WeActStudio/WeActStudio.MiniSTM32F4x1/Soft/README-zh.md

# 软件

* [English Version](./README.md)

1. `WeAct HID FW Bootloader` C语言开发程序下载工具，本工作室根据官方HID bootloader制作的图形化操作下载程序软件，更方便

2. `WeAct Studio Download Tool` 本工作室制作的下载工具，可以通过串口和USB下载程序或固件，可用于micropython固件的烧录或程序下载，非常好用，推荐！

3. `STM32_HID_Bootloader` C语言开发官方HID bootloader,想了解更多请访问
 <https://github.com/WeActStudio/STM32_HID_Bootloader.git>

4. `STM32CubeProgmmer` STM32官方下载工具,下载请访问[ST WebSite](https://www.st.com/content/st_com/en/products/development-tools/software-development-tools/stm32-software-development-tools/stm32-programmers/stm32cubeprog.html)

5. `WeActToolBox` 网络调试助手和串口调试助手

6. 更多软件 && `STM32CubeProgmmer` 等软件 百度云下载地址

``` c
链接：https://pan.baidu.com/s/1Ugz7GwJ0j41GaBrUv0c0Og 
提取码：lhla
```
