WeActStudio/WeActStudio.MiniSTM32F4x1/Soft/README.md

# Soft 软件

* [中文版本](./README-zh.md)

1. `WeAct HID FW Bootloader` C language development program download tool.Our studio according to the official HID Bootloader made graphical operation to download the program software, more convenient

2. `WeAct Studio Download Tool` Our studio produced download tools, can be through the serial port and USB download program or firmware, can be used for microPython firmware burning or program download, very easy to use, recommended!

3. `STM32_HID_Bootloader` C language development official HID Bootloader, want to learn more please visit
 <https://github.com/WeActStudio/STM32_HID_Bootloader.git>

4. `STM32CubeProgmmer` STM32 official download tool, download please visit[ST WebSite](https://www.st.com/content/st_com/en/products/development-tools/software-development-tools/stm32-software-development-tools/stm32-programmers/stm32cubeprog.html)

5. `WeActToolBox` Network speed view && Serial Port view widget

6. More software  && `STM32CubeProgmmer` BaiDu Downdown link:

``` c
链接：https://pan.baidu.com/s/1Ugz7GwJ0j41GaBrUv0c0Og
提取码：lhla
```
