WeActStudio/WeActStudio.MiniSTM32F4x1/SDK/README-zh.md

# SDK 描述

* [English Version](./README.md)

|目录名称|解释
|:--:|:--:|
|CMSIS-DAP|CMSIS-DAP 固件可以让我们的核心板刷成下载烧录器|
|MicroPython_Example|MicroPython 例程|
|STM32F401CEU6|STM32F401CEU6 相关资料.STM32F401CCU6 升级版本, 更大内存|
|STM32F411CEU6|STM32F411CEU6 相关资料|
