WeActStudio/WeActStudio.MiniSTM32F4x1/SDK/README.md

# The SDK description

* [中文版本](./README-zh.md)

|Dir name|Explain
|:--:|:--:|
|CMSIS-DAP|CMSIS-DAP Firmware allows the core board to be brushed into the download debugger|
|MicroPython_Example|MicroPython Example|
|STM32F401CEU6|STM32F401CEU6 related information.STM32F401CCU6 upgrade, more memory|
|STM32F411CEU6|STM32F411CEU6 related information.|
