WeActStudio/WeActStudio.MiniSTM32F4x1/SDK/CMSIS-DAP/README-zh.md

# CMSIS-DAP 固件

* [English Version](./README.md)

* 固件支持stm32f401ccu6,stm32f401ceu6,stm32f411ceu6
* 接口为核心板引出的SW调试接口

|我们的核心板|目标板|
|:--:|:--:|
|3V3|3V3|
|SWDIO|SWDIO|
|SWCLK|SWCLK|
|GND|GND|
