WeActStudio/WeActStudio.MiniSTM32F4x1/SDK/STM32F401CEU6/README-zh.md

* [English Version](./README.md)
## 目录说明

``` c
├─HAL             STM32 HAL库例程
├─MicroPython     MicroPython 固件
└─STD             STM32 标准库例程
```
