WeActStudio/WeActStudio.MiniSTM32F4x1/SDK/STM32F401CEU6/README.md

* [中文版本](./README-zh.md)
## Directory

``` c
├─HAL             STM32 HAL example
├─MicroPython     MicroPython firmware
└─STD             STM32 STD example
```
