WeActStudio/WeActStudio.MiniSTM32F4x1/SDK/STM32F401CEU6/STD/README-zh.md

# STD标准库示例程序

* [English Version](./README.md)

1. `stm32f4x1_Templates` 模板工程
2. `stm32f4x1_Templates_HIDFlash-easydownload` 模板工程&&HIDFlish APP
3. `stm32f4x1_TIM_PWMOutput` PWM 测试
