WeActStudio/WeActStudio.MiniSTM32F4x1/SDK/STM32F401CEU6/STD/README.md

# STD sample project

* [中文版本](./README-zh.md)

1. `stm32f4x1_Templates` Templates project
2. `stm32f4x1_Templates_HIDFlash-easydownload` Templates project&&HIDFlish APP
3. `stm32f4x1_TIM_PWMOutput` PWM test
