WeActStudio/WeActStudio.MiniSTM32F4x1/SDK/STM32F411CEU6/HAL/GPIO/GPIO_IOToggle/README.md

# HAL GPIO IO Toggle

This is a tutorial to implement a simple IO level reversal

# There are the creation procedures

## First: choose Pin and choose debug mode

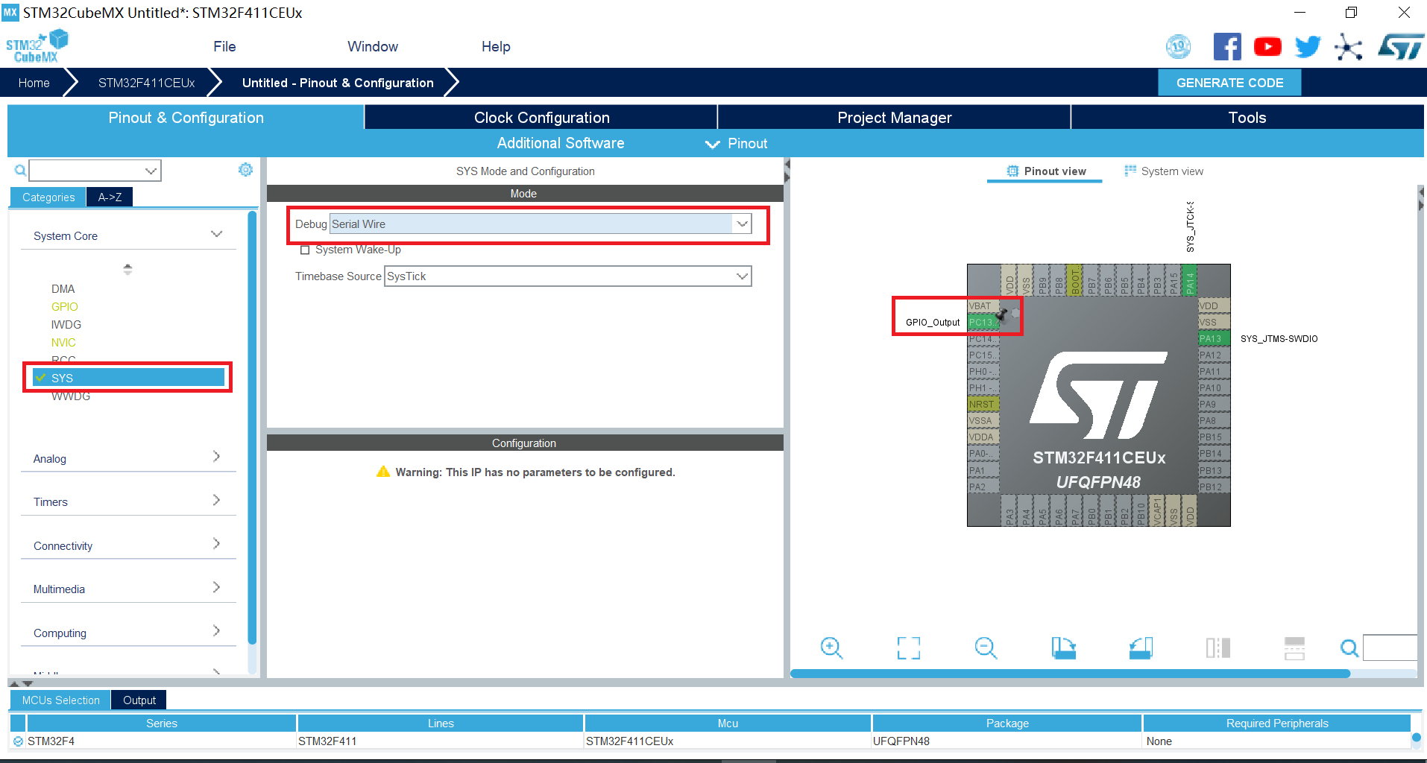
[picture p13: SDK/STM32F411CEU6/HAL/GPIO/GPIO_IOToggle/Images/1.PNG]
first


## Second: choose RCC and choose crystal resonator

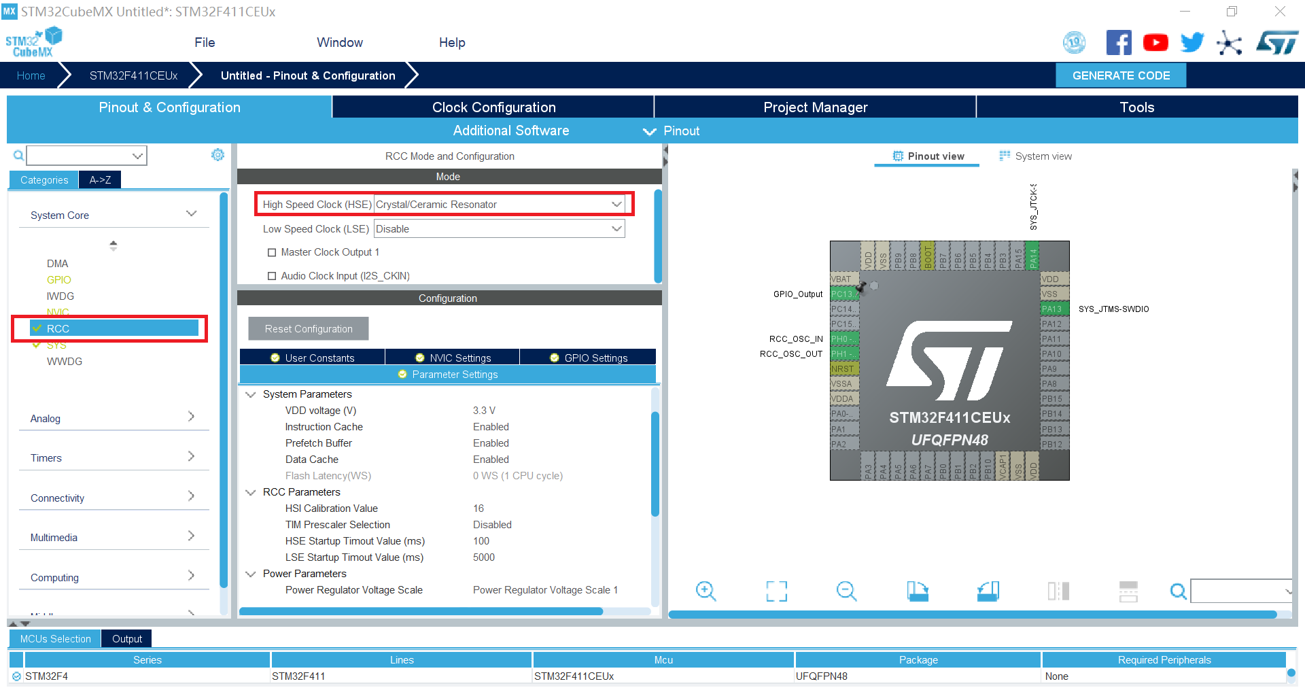
[picture p14: SDK/STM32F411CEU6/HAL/GPIO/GPIO_IOToggle/Images/2.PNG]
second


## Third: set GPIO attribute

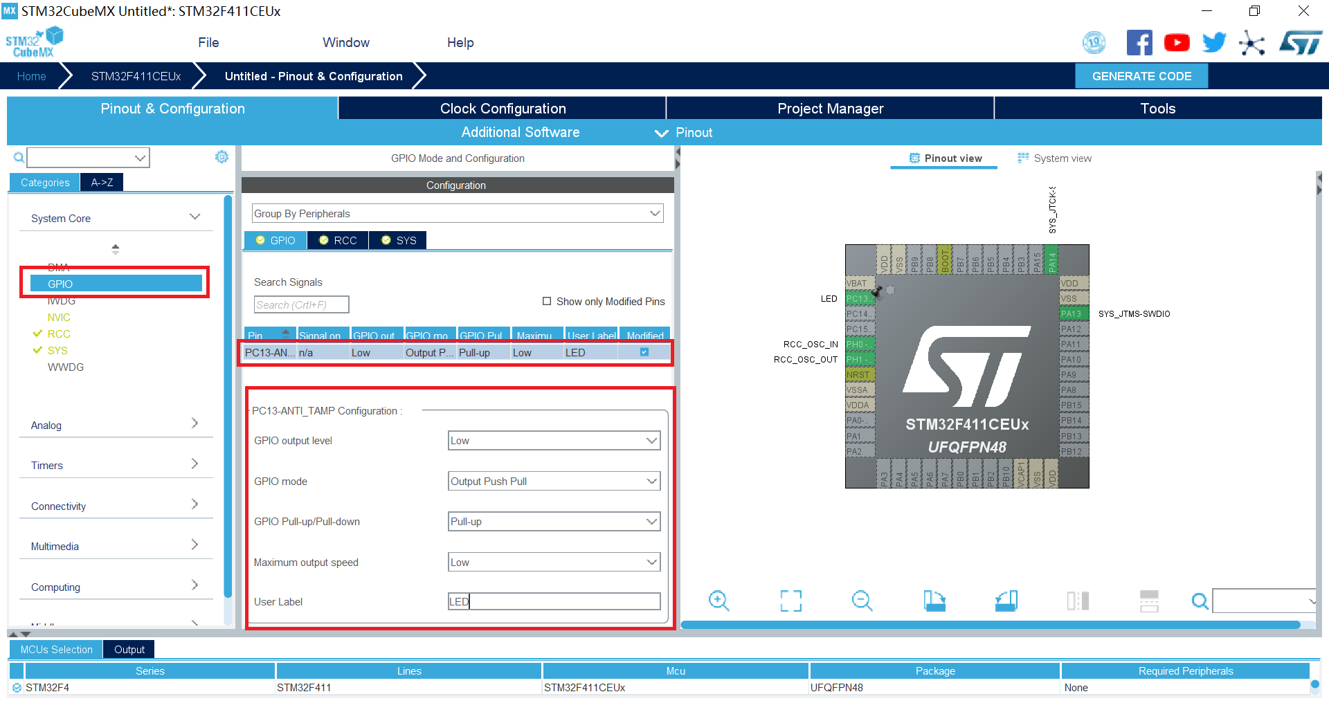
[picture p15: SDK/STM32F411CEU6/HAL/GPIO/GPIO_IOToggle/Images/3.PNG]
third


## Forth: clock configuaraton choose HSE

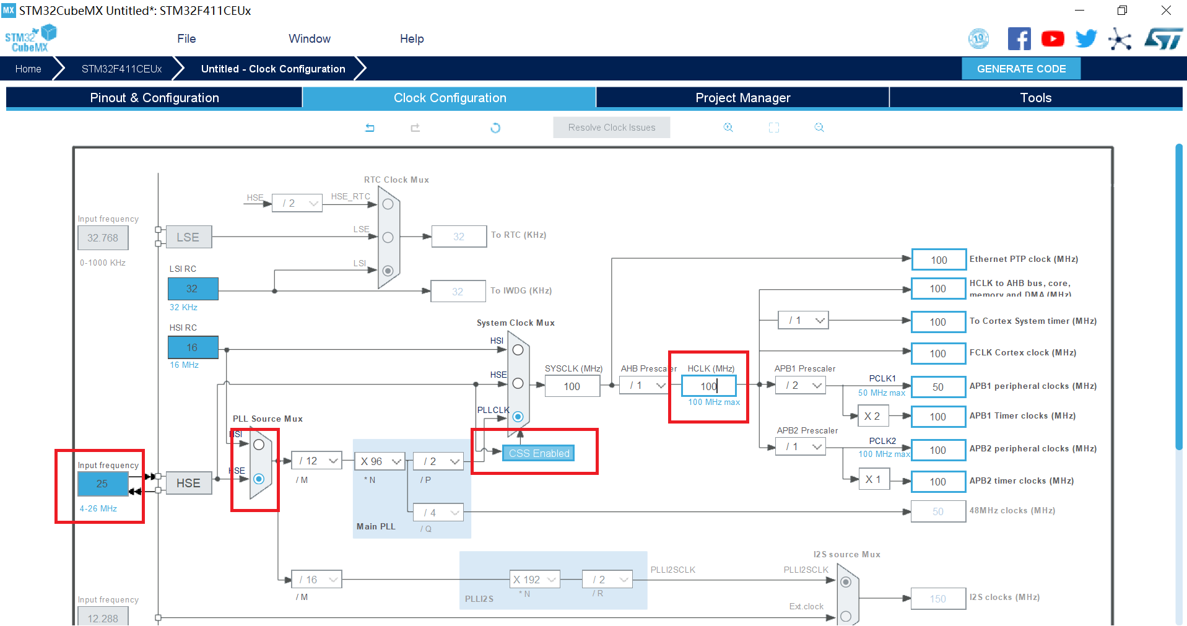
[picture p16: SDK/STM32F411CEU6/HAL/GPIO/GPIO_IOToggle/Images/4.PNG]
forth


## Fifth: set project name, location and your IDE

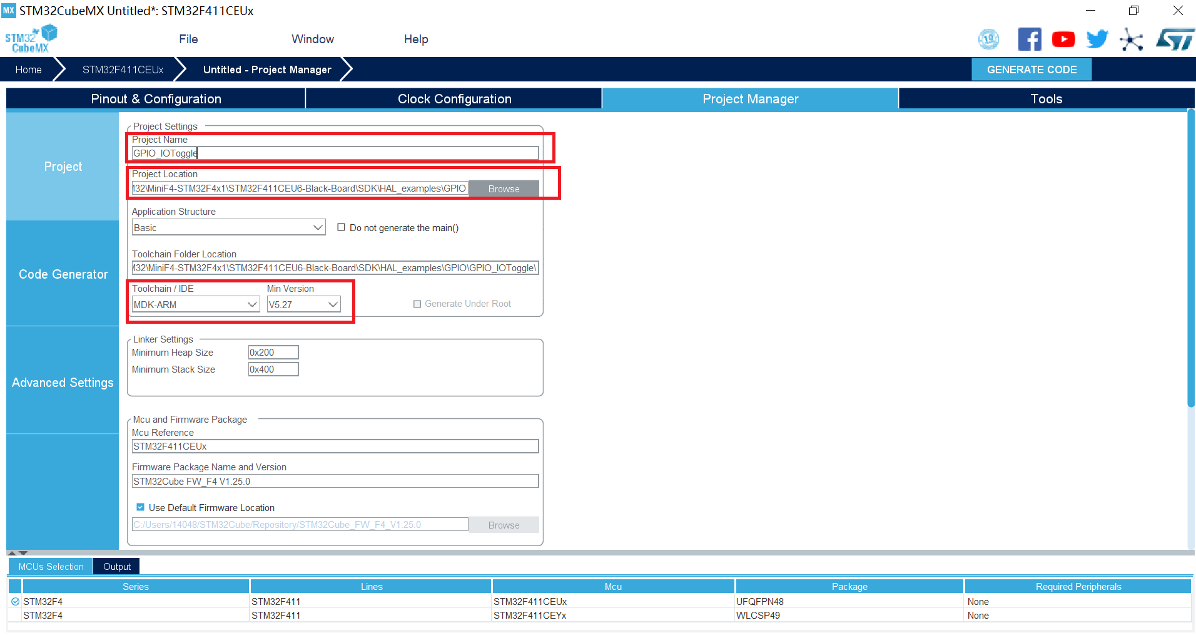
[picture p17: SDK/STM32F411CEU6/HAL/GPIO/GPIO_IOToggle/Images/5.PNG]
fifth


## Sixth: generate peripheral initialization(.c or .h) and generate the code

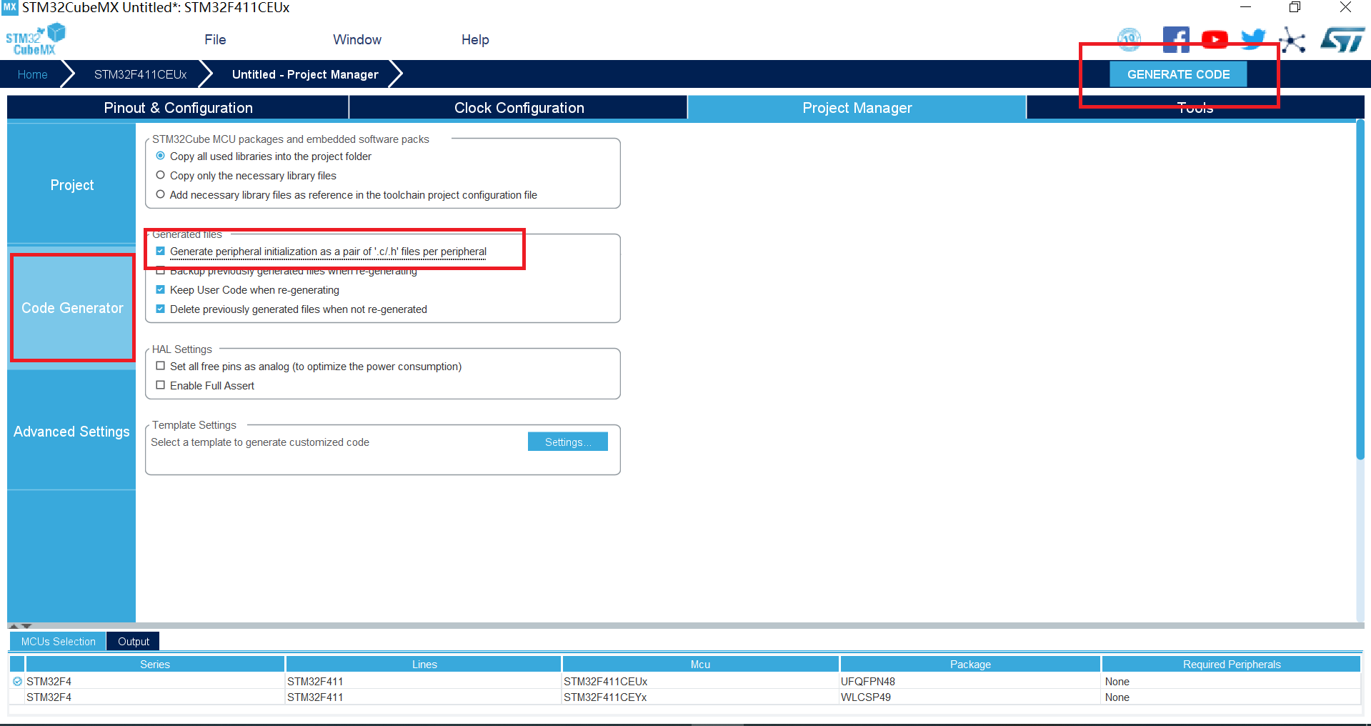
[picture p18: SDK/STM32F411CEU6/HAL/GPIO/GPIO_IOToggle/Images/6.PNG]
sixth
