WeActStudio/WeActStudio.MiniSTM32F4x1/Soft/WeAct_Toolbox/README.md

# WeAct ToolBox

## Network speed view && Serial Port view widget

## 网速查看&&串口查看小工具

V1.0 Initial Release

V1.1 Add KeyBoard `CAPSLOCK`&&`NUMLOCK` Display

V1.2 Add Mouse Double Click 
```
Double Click Network speed view Open Windows Start
Double Click COMx Open Device manager
Double Click KeyBoard Display Close `CAPSLOCK`&&`NUMLOCK`
```

> support English and Chinese

WLAN Tx:1 MB,Rx:1 MB
