WeActStudio/WeActStudio.MiniSTM32F4x1/SDK/STM32F401CEU6/HAL/06-F401_ST7735/README.md

# 重要说明 Important Note

* 中文：如果需要显示图片需要将图片为16位图

* English: If you want to display an image you need to make it a 16-bit image！
