WeActStudio/WeActStudio.MiniSTM32F4x1/images/F4x1Copy-1.png

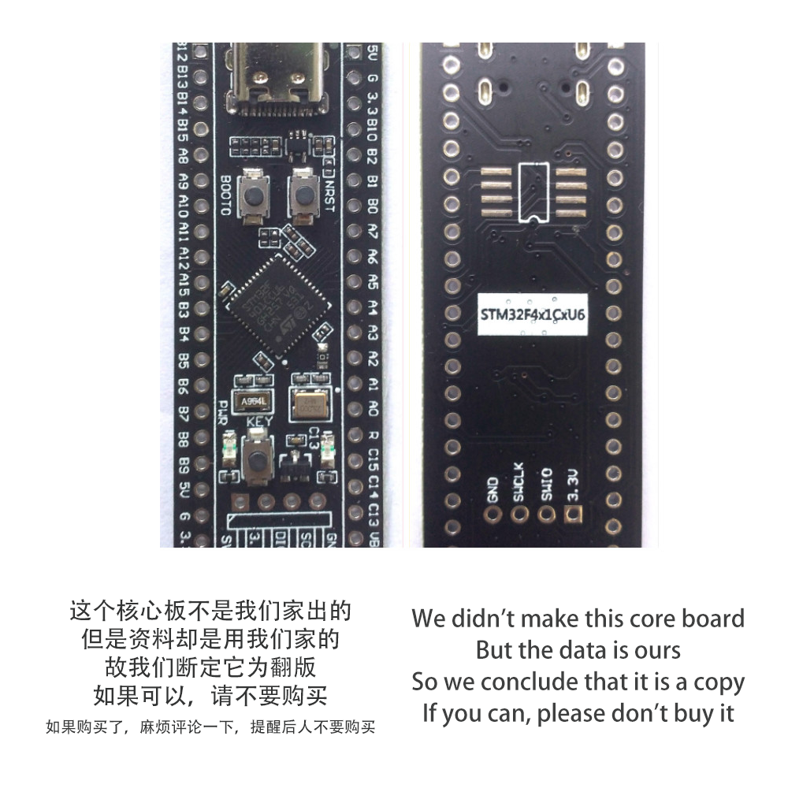
images/F4x1Copy-1.png
