WeActStudio/WeActStudio.MiniSTM32F4x1/images/STM32F4x1-V30_3D.jpg

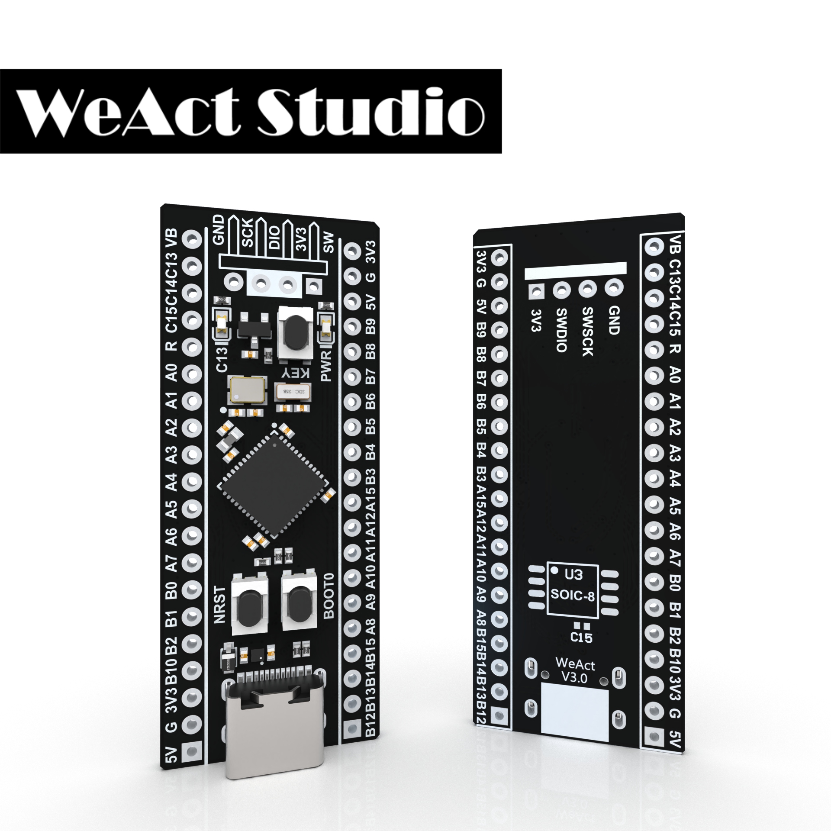
images/STM32F4x1-V30_3D.jpg
