WeActStudio/WeActStudio.MiniSTM32F4x1/images/STM32F401-3D-Model-Render/top&bottom.jpg

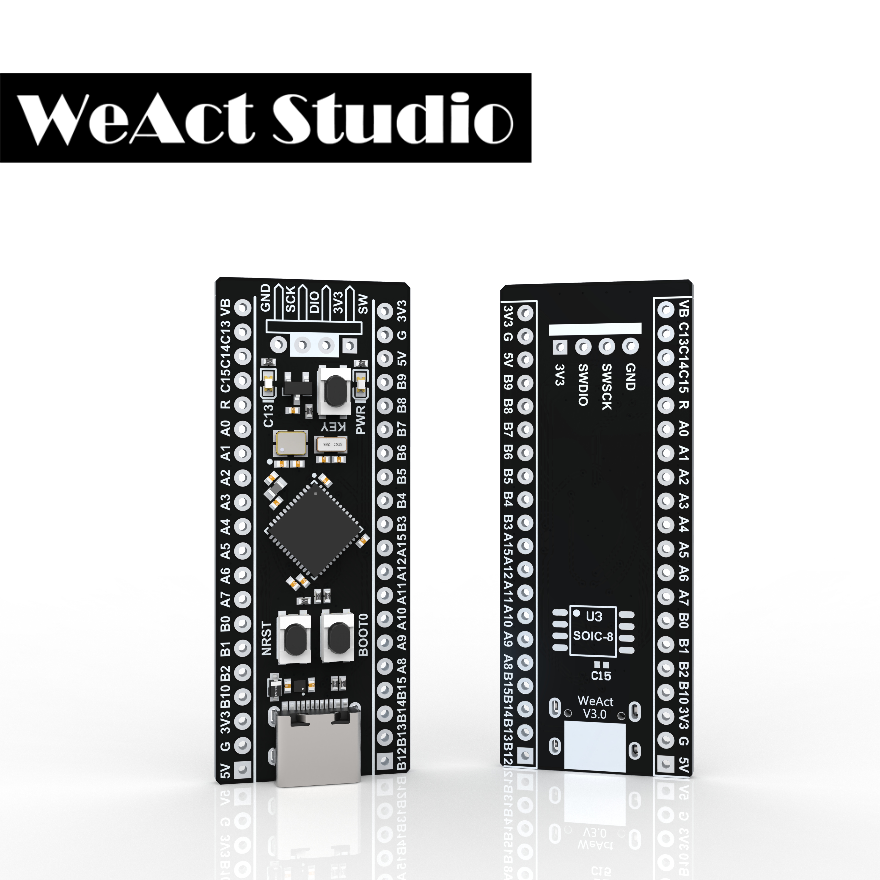
images/STM32F401-3D-Model-Render/top&bottom.jpg
