WeActStudio/WeActStudio.MiniSTM32F4x1/images/STM32F401-3D-Model-Render/top.jpg

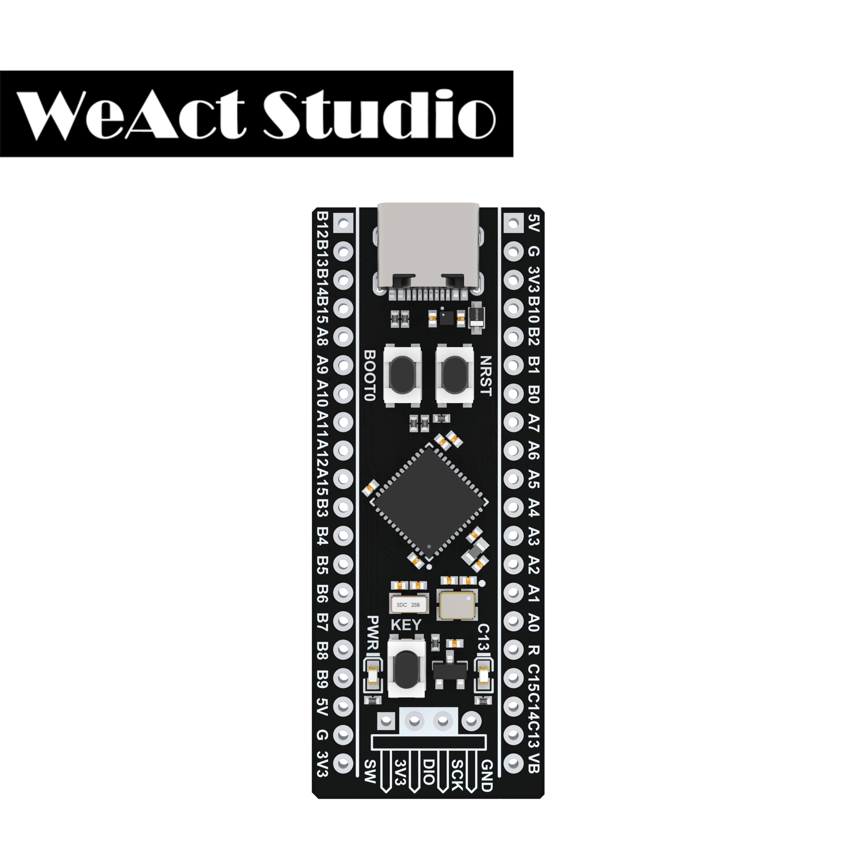
images/STM32F401-3D-Model-Render/top.jpg
