WeActStudio/WeActStudio.MiniSTM32F4x1/images/STM32F411-3D-Model-Render/side.jpg

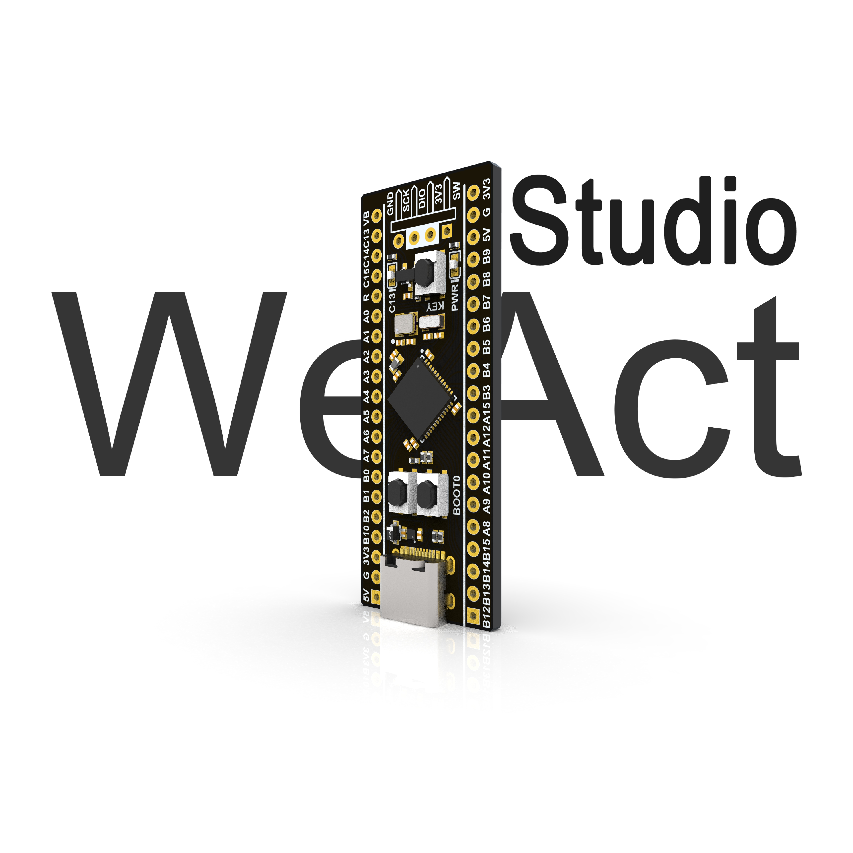
images/STM32F411-3D-Model-Render/side.jpg
