WeActStudio/WeActStudio.MiniSTM32F4x1/Soft/STM32_HID_Bootloader/pictures/Arduino_IDE_1_8_9.PNG

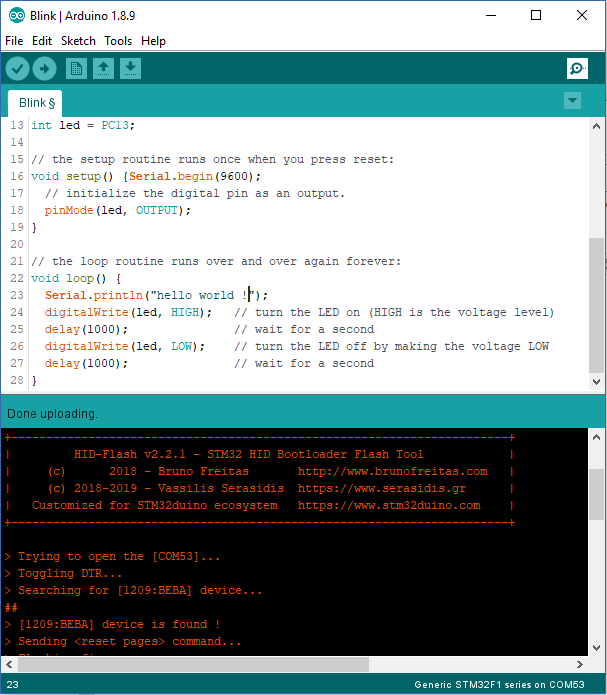
Soft/STM32_HID_Bootloader/pictures/Arduino_IDE_1_8_9.PNG
