WeActStudio/WeActStudio.MiniSTM32F4x1/(threads)

Thread 1 (2020-01-19):

Not powering on using USB-C cable with E-Mark

thinxer, 2020-01-19:
I'm having problem connecting the board to MacBook Pro with the default USB-C to USB-C cable, which has a E-Mark chip. The board is not powering on at all. It is working well with a USB-C cable without E-Mark, or a USB-A to USB-C cable.

Looking at the V20 Schematics, I noticed that the 2 CC pins are shorted. The board should have a 5.1kOhm pulldown resistor on each of the CC1 and CC2 lines, not shorting them.

It seems that Raspberry Pi 4B has made a similar mistake. Here is a in-depth analysis: https://hackaday.com/2019/07/16/exploring-the-raspberry-pi-4-usb-c-issue-in-depth/.

WeActTC, 2020-01-20:
Hi, because most USB-C cables do not have E-Mark chips, and this situation was not considered at the time, the board can work well with USB-C cables without E-Mark. Thanks for your feedback. We will improve in the next batch of products, each CC will add 5.1kΩ resistance.

thinxer, 2020-01-20:
Thanks for the response. I believe it should be better to leave this issue open so that we can track the progress. People experiencing the same issue thus could subscribe to this issue and get notified when the new batch is ready.

samveen, 2020-02-05:
@thinxer I noticed that V2.1 has one of the CC pins grounded via 5.1kOhm resister (R9), but not the other. Would you review: https://github.com/WeActTC/MiniF4-STM32F4x1/blob/master/STM32F401CCU6-Black-Board/HDK/MiniF4x1Cx_V21%20SchDoc.pdf

thinxer, 2020-02-05:
@samveen The two CC pins  are using the same PIN name and thus shorted, not that one of them is floating.

kamilion, 2020-02-20:
There needs to be two 5.1k ohm resistors to make e-marked cables work properly.

One for CC1, one for CC2.

Trying to share one resistor by linking both CC1 & CC2 together through the same resistor is what causes the E-mark problem.

This causes enumeration of the device as a passive headphone adapter that requires no power, and as such, none is delivered.

Also, the v2.1 board has another problem: Pressing Boot0 and Key at the same time causes a deadshort between 3.3v and GND. Another resistor like R6 added between key and ground will solve this current from becoming too large and causing the board to burn up due to unintended deadshort.

thinxer, 2020-03-02:
The issue has been resolved in V2.2 by e6cc12705.

Closed 2020-03-02.

Thread 2 (2020-01-28):

External power supply + USB at the same time

flatpedals, 2020-01-28:
Regarding the 411CE v1.3, is there any protection in place that would allow connecting USB and an external 5V source at the same time? Is this recommmended?
Thank you!

WeActTC, 2020-01-28:
Hello, it is not recommended to use external power supply and usb at the same time, because there is no diode protection. Common ground is fine, or connect a diode in a `5V Pin` to prevent current backflow to the usb.We will make corresponding improvements in the next hardware version

cgo, 2021-01-13:
Does this problem also persist in the 3.0 board with F401CEU?

flatpedals, 2021-01-13:
afaik, v3 has a diode in place for this specific issue. I had a v3 F411 for a short while and the diode was there but I didn't test. Maybe check the diagrams, but I think it has been fixed.

cgo, 2021-01-13:
Thanks @flatpedals

Thread 3 (2020-02-04):

Schematics missing

samveen, 2020-02-04:
The repository is missing the schematics of the board. I am trying to understand how to attach an SPI flash memory chip to the F401 version of the board, but without the schematics, I am unable to figure out the details.

WeActTC, 2020-02-04:
Hi,
The schematic of F401 is here：
[https://github.com/WeActTC/MiniF4-STM32F4x1/tree/master/STM32F401CCU6-Black-Board/HDK](https://github.com/WeActTC/MiniF4-STM32F4x1/tree/master/STM32F401CCU6-Black-Board/HDK)
And STMF401 V1.2 version  has been discontinued because of piracy.

samveen, 2020-02-05:
Ah. My mistake. Thank you.

Thread 6 (2020-03-22):

Can it have USB Type A female socket?

probonopd, 2020-03-22:
Can it have USB Type A female socket? So that one can plug in normal USB devices for OTG/host mode.

WeActTC, 2020-03-23:
Yes，You can use OTG cable (USB C to USB A), if board version is V2.2 or above, need to short  diode D4, then external supply 5V power

Closed 2020-03-23.

Thread 7 (2020-04-27):

3D model

macaba, 2020-04-27:
Please add a 3D model of STM32F411CEU6-Black-Board in STEP format.

RusikOk, 2020-05-15:
https://youtu.be/9pfycyA8zBE 3D Model Development Guide in Altium

DmNosachev, 2020-11-23:
@macaba, here you go: [minif4_stm32f401_stm32f411_board.step](https://cxemka.com/upload/art/f411/minif4_stm32f401_stm32f411_board.step)

RusikOk, 2020-11-23:
@macaba, day Bog tebe zdorovya))

WagnerDeQueiroz, 2023-07-13:
Anyone has this 3D model in STL or OBJ?
I like to import this board to Blender3D for video education...
I buyed the V3.0 board and I love it this platform. Very fast chip!

Thread 8 (2020-05-12):

Documentation : how to flash blink example and run it using WeAct_HID_Bootloader

XavierBerger, 2020-05-12:
A documentation explaining how to upload a simple blink program could be a great value for this board. Such example is very valuable for people starting using such a new board.
I looked for such example but I didn't find it. After few tries, I manage to see the LED blinking, but I think I finally accidentally erase the bootloader.

A additional valuable documentation could be how to install WeACT_HID_Bootloader using USBtoSerial adapter.

----

To help you in doc writing, here is what I did. You may find some mistakes to be documented:

Running on Linux (Ubuntu Fosa) I plugged the F401 and saw WeAct_HID_bootloader with LED fading up and down. I press tke KEY and led turned OFF. I saw STM32_HID_bootloader.
I did configure platformio to use `dfu` to upload the blink (framework adruino) example. The DFU gave ma an error (see bellow). After reboot, the LED is blinking but I cannot see anymore the boot loaders...
```
[...]
Linking .pio/build/blackpill_f401cc/firmware.elf
Checking size .pio/build/blackpill_f401cc/firmware.elf
Advanced Memory Usage is available via "PlatformIO Home > Project Inspect"
RAM:   [          ]   1.3% (used 880 bytes from 65536 bytes)
Flash: [          ]   3.9% (used 10220 bytes from 262144 bytes)
Building .pio/build/blackpill_f401cc/firmware.bin
Adding dfu suffix to firmware.bin
dfu-suffix (dfu-util) 0.9

Copyright 2011-2012 Stefan Schmidt, 2013-2014 Tormod Volden
This program is Free Software and has ABSOLUTELY NO WARRANTY
Please report bugs to http://sourceforge.net/p/dfu-util/tickets/

Suffix successfully added to file
Configuring upload protocol...
AVAILABLE: blackmagic, dfu, jlink, serial, stlink
CURRENT: upload_protocol = dfu
Uploading .pio/build/blackpill_f401cc/firmware.bin
dfu-util 0.9

Copyright 2005-2009 Weston Schmidt, Harald Welte and OpenMoko Inc.
Copyright 2010-2020 Tormod Volden and Stefan Schmidt
This program is Free Software and has ABSOLUTELY NO WARRANTY
Please report bugs to http://sourceforge.net/p/dfu-util/tickets/

Match vendor ID from file: 0483
Match product ID from file: df11
Opening DFU capable USB device...
ID 0483:df11
Run-time device DFU version 011a
Claiming USB DFU Interface...
Setting Alternate Setting #0 ...
Determining device status: state = dfuERROR, status = 10
dfuERROR, clearing status
Determining device status: state = dfuIDLE, status = 0
dfuIDLE, continuing
DFU mode device DFU version 011a
Device returned transfer size 2048
DfuSe interface name: "Internal Flash  "
Downloading to address = 0x08000000, size = 10656

Erase           [                         ]   0%            0 bytes
Erase           [====                     ]  19%         2048 bytes
Erase           [=========                ]  38%         4096 bytes
Erase           [==============           ]  57%         6144 bytes
Erase           [===================      ]  76%         8192 bytes
Erase           [======================== ]  96%        10240 bytes
Download        [                         ]   0%            0 bytes
Download        [====                     ]  19%         2048 bytes
Download        [=========                ]  38%         4096 bytes
Download        [==============           ]  57%         6144 bytes
Download        [===================      ]  76%         8192 bytes
Download        [======================== ]  96%        10240 bytesdfu-util: Error during download get_status

Download        [=========================] 100%        10656 bytes
Download done.
File downloaded successfully
*** [upload] Error 74
```

XavierBerger, 2020-05-13:
Let me answer to my second question: **How to flash Weact HID Bootloader?**

On Linux, download  WeAct_HID_Bootloader_F4x1.hex from this repoitory and execute the following command:
```bash
objcopy -Iihex -j .sec1 -Obinary WeAct_HID_Bootloader_F4x1.hex WeAct_HID_Bootloader_F4x1.bin
dfu-suffix -a WeAct_HID_Bootloader_F4x1.bin
dfu-util -a 0 -s 0x08000000 -D WeAct_HID_Bootloader_F4x1.bin
```

Thread 9 (2020-05-15):

USER KEY CONNECTED TO?

roboter, 2020-05-15:
I Have version 3.0
And there a user KEY, but it missing in schematic and in pin diagram.

roboter, 2020-05-15:
Found it PA0

Closed 2020-05-15.

Thread 10 (2020-07-14):

Micropython is crashing while trying to use UART6

rdidyk, 2020-07-14:
Hello,
I've troubles with board while using UART6
every time when I'm trying to initialize it micropython is crashing and board goes offline

code example:
`from machine import UART`
`gps = machine.UART(6, 9600)`

Thanks in advance,
Ruslan

WeActTC, 2020-07-16:
UART6: `TX-PA11`,`RX-PA12`
USB: `DN-PA11`,`DP-PA12`
UART6 conflicts with USB. If use UART6, USB will be invalid and board goes offline

Thread 15 (2020-09-29):

How is "blackpill" ADC analog voltage supplied?

derek-eder, 2020-09-29:
I am interested in the ADC analog voltage supplies - specifically VDDA and Vref+

Is it possible to isolate these and supply the analogy voltage from an external supply?   One developer, Martin Loren, says he "removes a shunt" on the blackpill board and supplies an external Vref+ to board pin PA2 but I can't find any blackpill board schematics or PCB layout to get more details.

STM provided a seperate analog supply to the ADC for a very good reason and I would like to be able to use them in the Blackpill or some future iteration.

Many thanks!

Derek Eder

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

WeActTC, 2020-09-30:
STM32F411CEU6 Only VDDA, no VREF.
You can use one ADC specifically to read the voltage from the external reference source, and then another ADC to sample what you need, and compare the two.
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

Thread 16 (2020-10-05):

WeAct Studio WeiXing Store on AliExpress

fivdi, 2020-10-05:
Are the products available at the [WeAct Studio WeiXing Store](https://aliexpress.com/store/910567080) on AliExpress original WeAct Studio products?

DavidCampbellTech, 2020-10-05:
If you look at the react GitHub page, they list “safe” shops to buy from:

https://github.com/WeActTC/MiniF4-STM32F4x1

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

WeActTC, 2020-10-05:
Yes, our official store

fivdi, 2020-10-05:
Excellent. Maybe you could add it to the AliExpress legal purchase list [here](https://github.com/WeActTC/MiniF4-STM32F4x1#aliexpress-legal-purchase-link).

WeActTC, 2020-10-06:
OK

Closed 2020-12-01.

Thread 23 (2021-01-06):

Power supply for connecting USB keyboard

pbadun, 2021-01-06:
Good day. After making changes and adding a diode starting from version 2.2, you cannot connect the USB keyboard, because it is not receiving power. You have to close the diode. Is it possible to solve this in some other way without having to change the board itself?

Thread 24 (2021-01-12):

Making USB OTG work with the Blackpill V3.0 board

cgo, 2021-01-12:
Hi,
I have a v3.0 blackpill board with a F401CEU chip.
I am not certain if it is possible to implement a portable USB host with this board; it would need external power and
I would like to use the USB-C connector to connect self-powered devices to it.
Is that possible and if yes do you have some information on how I would have to set up VBUS and power for the board,
and if I need any external parts apart from the blackpill board itself?

Thanks a lot.

cgo, 2021-01-15:
Did a little bit of reading; does the blackpill board have a charge pump installed on the board?

Thread 25 (2021-04-13):

5V measured on the 3.3V pins

szszoke, 2021-04-13:
Hello!

I got two Blackpill V3 boards with the F411CE and when they are connected via the USB cable to my computer, I can measure 5V on both the 5V and the 3.3V pins.

I checked and they are not shorted. Is this normal?

szszoke, 2021-04-13:
If I am reading the schematic correctly, the 3.3V pins should be connected to the output of the 3.3V regulator.

WeActTC, 2021-04-13:
I think the LDO failed, maybe your board is not made by us, it is one of the copy board, this board, if you short circuit 3v3 and GND, LDO will fail, it can not output 3.3V, instead of output 5V. The worst part is that it printed our version number and logo, and placed a Github link on AliExpress's product details page

szszoke, 2021-04-14:
I have two boards, new, and they both exhibit this issue.

szszoke, 2021-04-14:
Where is the LDO located on the board? I'm guessing it is U2 on the schematic but it is not marked on the board.

szszoke, 2021-04-15:
I ended up doing more testing and I found that the boards have a 5V regulator instead of a 3.3V regulator.

Dreadrik, 2022-01-23:
> I ended up doing more testing and I found that the boards have a 5V regulator instead of a 3.3V regulator.

I just received two boards with the exact same issue. Bought them from a reputable seller as well. Did you manage to replace the regulator, or did you return the boards?

szszoke, 2022-01-23:
I still have the old boards but I got replacements. The replacement boards had really straight edges on the PCB while the bad ones looked like they were marked with a saw and then broken off.

Dreadrik, 2022-01-23:
Ok, thanks! Mine look straight, has the WeAct logo and the V3.0 version number and everything. I think I'll have to make a claim for replacements as well.

fivdi, 2022-01-23:
The version number of the latest boards has been V3.1 for quite some time now.

See https://www.aliexpress.com/item/1005001456186625.html.
See also https://github.com/WeActTC/MiniSTM32F4x1/tree/master/HDK.

Closed 2021-04-15.

Thread 26 (2021-04-13):

Flashing via ST-Link V3

szszoke, 2021-04-13:
Hello!

I have two of the V3 boards with the F411CE and I am unable to make my ST-Link V3 detect the chips.

My ST-Link is running the `V3J7M3B5S1` firmware, which as far as I know is that latest one.

I am trying to program via SWD.

Here are my connections
-------------------
| ST-Link V3 | Board |
| ---------- | --------- |
| GND | GND |
| VCC | 3V3 |
| CLK | SCK |
| DIO | DIO |
| NRST | R |

I also tried without the NRST line being connected but still no chip detected.

The board is plugged in via USB and is running an Arduino blink example, which was uploaded via DFU mode.

I made sure with a multimeter that my connections are good.

```
st-info --probe
Found 1 stlink programmers
 serial:     303033413030314533303339353130383334333933383338
 hla-serial: "\x30\x30\x33\x41\x30\x30\x31\x45\x33\x30\x33\x39\x35\x31\x30\x38\x33\x34\x33\x39\x33\x38\x33\x38"
 flash:      0 (pagesize: 0)
 sram:       0
 chipid:     0x03e8
```

```
openocd -f interface/stlink.cfg -f target/stm32f4x.cfg                                                                                                                                                                                                                    
Open On-Chip Debugger 0.11.0
Licensed under GNU GPL v2
For bug reports, read
	http://openocd.org/doc/doxygen/bugs.html
Info : auto-selecting first available session transport "hla_swd". To override use 'transport select <transport>'.
Info : The selected transport took over low-level target control. The results might differ compared to plain JTAG/SWD
Info : Listening on port 6666 for tcl connections
Info : Listening on port 4444 for telnet connections
Info : clock speed 2000 kHz
Info : STLINK V3J7M3B5S1 (API v3) VID:PID 0483:374F
Info : Target voltage: 4.638830
Error: init mode failed (unable to connect to the target)
```

STM32CubeProgrammer is also failing to connect to the chip:
```
  01:34:00 : STM32CubeProgrammer API v2.7.0
  01:34:16 : ST-LINK SN  : 003A001E3039510834393838
  01:34:16 : ST-LINK FW  : V3J7M3B5S1
  01:34:16 : Board       : STLINK-V3SET
  01:34:16 : Voltage     : 4,60V
  01:34:16 : No STM32 target found!
  01:34:16 : ST-LINK SN  : 003A001E3039510834393838
  01:34:16 : ST-LINK FW  : V3J7M3B5S1
  01:34:16 : Board       : STLINK-V3SET
  01:34:16 : Voltage     : 4,57V
  01:34:16 : Error: No STM32 target found!
```

Holding the reset button while trying to connect to the chip doesn't work either.

I tried this both on Linux and Windows. Is there something that I am missing here?

denizzzka, 2021-04-14:
>openocd -f interface/stlink.cfg -f target/stm32f4x.cfg

Try to use `target/stm32f1x.cfg` config

szszoke, 2021-04-14:
I tried it but it didn't work.

I think I'm dealing with counterfeit chips here.

The 3.3V line is at 5V, and the STM32 is also getting 5V.

I have two boards from the same store and they are both behaving like this (including 5V at the 3.3V line)

denizzzka, 2021-04-14:
Can you also check your St-link device to ensure that its VCC output it is not source of +5V?

szszoke, 2021-04-15:
Turns out my boards have a 5V regulator instead a 3.3V one, so I'm getting a set of new ones.

I will report back when they arrive.

denizzzka, 2021-04-16:
> Turns out my boards have a 5V regulator instead a 3.3V one, so I'm getting a set of new ones.

My (unofficial) ST-Link V2 provides 3.3V output pin, maybe V3 also does?

szszoke, 2021-04-19:
As far as I know the official ST-Link programmers do not power the target.

I got my replacement boards which seem to be working and are detected correctly by ST-Link as well.

Closed 2021-04-19.

Thread 27 (2021-04-14):

stm32 xtal oscillator need Rext

cypacmori, 2021-04-14:
The XTAL oscillator in the MiniSTM32F4x1 schematic is considered to be above the (DL: Drive Level) of XTAL.
Please refer to ST Application note AN2867 and add (RExt: external resistor to limit the inverter out).
https://www.st.com/resource/en/application_note/cd00221665-oscillator-design-guide-for-stm8afals-stm32-mcus-and-mpus- stmicroelectronics.pdf
Please refer to chapter 3.
SMD XTAL DL of 100-150µW is recommended, 300-400µW max. (2016 size)

Translated with www.DeepL.com/Translator (free version)

Thread 28 (2021-04-15):

digitalWrite outputs 3.3V even though the board is 5V feeded

Akrai, 2021-04-15:
So I'm trying to figure this out, I thought the board should output, when using digitalWrite (stm32duino), 5V if the board is 5V powered, and 3.3V if it is 3.3V powered, but I'm getting 3.3V on all the pins I write with the board being 5V powered.

luuke, 2021-04-15:
Microcontroller is supplied with 3.3V and so it outputs such voltage.

Hackswell, 2021-04-15:
I believe that the chip itself is 3V3.  It can accept 3V3 or 5V input, but it's converted into 3V3 for the chip.  If you need the pins to output 5V, you'll need to step it up with a converter.  (I have to do this with my NeoPixel LED strips)

Akrai, 2021-04-15:
But for example, with an arduino nano it behaves like i want, 5V if it is 5V powered, but the chip on the nano is 3.3V powered, am i right?

Are other STM32 boards behaving like this?

luuke, 2021-04-15:
Arduino Nano has ATmega chip which is 5V. It can work with 3.3V. STM32 are 3.3V and applying 5V to it might damage it.

Akrai, 2021-04-15:
Okay, I just want to make very sure that the board won't output on any I/O pin 5V under any circumstance, as I won't be using a digital shifter to protect a TFT screen (as those don't work if input and output is 3.3V) which will break if it gets 5V

Hackswell, 2021-04-15:
Correct.  From everything I can see, INPUTS can be 3V3 or 5V (on most pins... see the chart I made for which pins on F411 aren't 5V tolerant).  OUTPUTS are 3V3.

[https://github.com/WeActTC/MiniSTM32F4x1/blob/master/images/STM32F4x1_PinoutDiagram_RichardBalint.png](url)

Akrai, 2021-04-15:
Thanks!

Closed 2021-04-15.

Thread 29 (2021-11-01):

STM32L4xx for significantly better USB support

StefanBruensLC, 2021-11-01:
The USB OTG FS controller in the F401/F411 is severely crippled, as it support only 3 USB Endpoints per direction, which makes it impossible to implement more than 1 USB CDC interface (1 Bulk IN and 1 Interrupt IN required per interface).

The L4xx support 6 endpoints per direction, so up to 3 USB CDC could be supported, or a variety of other compositions.

The L4xx are mostly pin compatible with the F401/F411 (and are fully compatible with the BlackPill schematic).

Given the BluePill+ (which does not have these restrictions) is completely unavailable, this would be very welcome.

Thread 32 (2021-12-30):

Dismal quality of onboard buttons

j-inc, 2021-12-30:
I have so far purchased two of this board from retailers offering authentic versions. They are not clones.

On both the boot0 button has come apart, making it quite difficult to enter bootloader mode once they have com apart. I've had to purchase an ST-Link just to make the boards functional once again.

Please, please break out the boot0 pin in a future revision of this board and use a higher quality SMT button so other users don't have to deal with this.

Thread 33 (2022-01-15):

ESD Protection

build-fails, 2022-01-15:
The MiniSTM32H7xx board has ESD Protection applied. Not applicable to MiniSTM32F4x1.

Thread 34 (2022-03-07):

Where I can buy original STM32F401CEU6 model Black Pill?

nanoant, 2022-03-07:
I want to buy STM32F401CEU6 @ 84Mhz 512KB ROM 96KB RAM Black Pill model (as listed in README), but it is not available anywhere. I can find only lot of old STM32F401CCU6 clones all around Aliexpress, but I'd prefer to buy original.

Official [WeAct Studio Official Store](https://weactstudio.aliexpress.com/) lists only more expensive STM32F411CEU6. Is there any chance to get cheaper ($3?) STM32F401CEU6 on stock?

I need to cheap ARM board for radio communication for kids, but STM32F411 is tad too expensive. I like STM32F401 as it is cheap and provides 5V tolerant pins and enough RAM and ROM. But otherwise I'd use Rpi Pico, which however has no 5V tolerant pins.

kmkaczor, 2022-03-13:
I think WeAct stopped making those, so you're going to have to buy one of the clone boards.

Otherwise, there is a STM32F40 Nucleo kit on digikey for about , but that's a bit different.

You could look into the Nuvoton M051, I have no experience with it, but I think it is 5v tolerant and quite cheap.

Thread 35 (2022-05-08):

Is it possible to program the WeActV3.0 with STM32CubeIDE?

dddomodossola, 2022-05-08:
Hello,

I would like to program the Weact v3.0 with STM32CubeIDE.
Do you provide a .ioc file? Or which board to select?

Kind Regards.

zoggn, 2022-05-08:
Of course it is possible. Just select stm32f411 or f401.

dddomodossola, 2022-05-08:
Thank you for the fast reply.
But, this way I have to configure hardware manually. Doesn't it?

zoggn, 2022-05-08:
> Thank you for the fast reply. But, this way I have to configure hardware manually. Doesn't it?

You do. That's an development board, not a ready device. So, you could configure it whatever you want for your needs

dddomodossola, 2022-05-08:
:-D That's true

cshawky, 2022-05-08:
Hi David.
The hour or so you spend with STMCubeMX (not STM32CubeIDE) to create your own IOC file is well worth it. Consider it a training session. If you are already ofay with MX then it should only take about 5 minutes to mock up any of the WeAct devices. I have been doing exactly that as part of my learning curve.
When you use MX directly it effectively gives you the opportunity to create a separate MX project which then becomes a template for the IDE, that you can re use.
I suggest you start with the latest Schematic to do your pin assignments.

dddomodossola, 2022-05-09:
@cshawky thank you. I preferred to not to use Arduino IDE because it is a really poor environment.
Furthermore I want to learn ST sdk because I will start a commercial project in industrial environment, and I want complete understanding about the device.

cshawky, 2022-05-09:
Same same. I am having a look at Arduino, Block coding support etc as one solution I am putting together would be ideal if the client could maintain his control logic. The client is not a programmer. My son and I prototyped his requirement using Scratch! Middle ground might be the Arduino IDE, if the embedded block code ends up being no good (I'm not seeing recent updates in that space).
I started with the STM32VLDiscovery and grabbed two Black Pills online (eBay) as the VL ST-LINK V1 interface is no longer supported. Unfortunately or fortunately I have returned the Black Pills to the vendor, not fit for purpose and order two from WeAct directly (almost the same price) once I realised potential copying.
This is off topic but the first unit worked fine via ST-LINK V2. I plugged in USB-C once but never used the USB interface. After a weekend of developing, I went to use the second unit but it did not power up. No 3.3V rail. Power from USB was 4.98V. So I plugged USB-C into the unit I had been using the ST-LINK, and got 4.8Vdc on the 5V rail and 4.5Vdc on the 3.3V rail. By the time I had finished videoing and comparing with a multimeter to put a case for replacement the first unit also died. i.e. 4.5V fried it.
Long story short the little voltage regulator wasn't any good. My concern now is that the genuine Mini from WeAct will be no different as for the life of me I could not pick any difference. The units I had were stamped WeAct 3.0 and of good build quality.

cshawky, 2022-05-15:
I have uploaded my IOC definition for this board to https://github.com/cshawky/STM32CubeMX

dddomodossola, 2022-05-15:
@cshawky Thank you a lot ;-)

cshawky, 2022-05-16:
I ran out of time to post my sample app which I feel would be helpful for PWM setup. Please post a comment on my repository in the discussions section to give feedback for others to benefit. More than happy to hear how you fared. I am just a novice with the STM32 kit.

Closed 2022-05-08.

Thread 36 (2022-05-08):

English document version

dddomodossola, 2022-05-08:
Hello,

Is it possible to have an english version of this document? [General document/STM32部分下载烧录问题汇总 _WeAct工作室.pdf](https://github.com/WeActTC/MiniSTM32F4x1/blob/master/General%20document/STM32%E9%83%A8%E5%88%86%E4%B8%8B%E8%BD%BD%E7%83%A7%E5%BD%95%E9%97%AE%E9%A2%98%E6%B1%87%E6%80%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)

Thread 37 (2022-06-02):

DOC: where are the sources for the original firmware uploaed when purchasing the device?

ankostis, 2022-06-02:
From all this repo i missing a link to the source-code that generated the firmware that is running my stm32f401-v1.2 device when it arrived.

Actually i'm missing a list in the landing `README.md` of this repo explaining what each folder & file is.

Thread 38 (2022-06-11):

Bug with ST32F411CEU6 V3.1 in arduino programming, Platformio and STM32LowPower lib (STM32duino Low Power)

sfekilou, 2022-06-11:
With Black Pill ST32F411CEU6, arduino coding, platformio

If the code is:
`
void setup() {
  pinMode(LED_BUILTIN, OUTPUT);
}

void loop() {
  digitalWrite(LED_BUILTIN, HIGH);
  delay(1000);
  digitalWrite(LED_BUILTIN, LOW);
  delay(1000);
}`

The LED is blinking.

But if the code is:
`
#include <STM32LowPower.h> //Last STM32duino Low Power lib
void setup() {
  pinMode(LED_BUILTIN, OUTPUT);
  LowPower.begin();
}

void loop() {
  digitalWrite(LED_BUILTIN, HIGH);
  LowPower.deepSleep(2000);
  digitalWrite(LED_BUILTIN, LOW);
  LowPower.deepSleep(2000);
}
`
The LED does not blinking
What is the problem ?
Do you know a method to perform a deepsleep ?

Thread 39 (2022-08-10):

10k resistor (R3) between PB2 and GND

dikdom, 2022-08-10:
On Blackpill, STM32F4x1.
Why is it needed?

fivdi, 2022-08-10:
PB2 is the BOOT1 pin. For further information see the "Boot configuration" section of the reference manual.

Thread 40 (2022-08-18):

Board improvement

kaizen75, 2022-08-18:
I am currently working on a battery powered sensor node. For data storage I have attached a W25Q32 EEPROM to the board. The EEPROM works fine, but when I switch to standby mode on the STM32 using the HAL_PWR_EnterSTANDBYMode() function. The EEPROM still consumes 1-2mA which is very much higher than the uA level current it should do.
The problem lies in the fact that PA4 (CS) goes low when the STM32 goes into standby and therefore /CS for the EEPROM is active which causes the chip to become active and consume 1-2mA. I found the solution to be to place a pullup resistor of 100k-1M between pin 1 (/CS) and pin 8 (3V3). In my case the current went down to 3uA. Maybe it is a board improvement to include unpopulated pads for this resistor just like there are unpopulated pads for the decoupling capacitor for the EEPROM on the bottom side of your board.

Thread 44 (2023-07-19):

Whether or not the PA10 port burned out from a level of 5 volts

brightproject, 2023-07-19:
Hello @WeActStudio.
When designing the board on which BlackPill `stm32f401ccu6` was planned to be placed, I made a mistake when creating the `CH340G` circuit.
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
It was necessary to power the microcircuit from `3.3 volt`, either through a converter, or two diodes.
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
Or use a level shifter.
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
But that's all I'll do in the next PCB.
In general, I soldered the board, and it turns out that 5 volts were supplied to `PA9` and `PA10`.
My schematic(((
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
Pins `TX/RX` have a voltage level of the `CH340G` microcircuit, namely about `4.7-4.9` volts.
And this level was fed to the inputs `PA9/PA10`, where 3.3. volt...
The most interesting thing is that the whole scheme worked and gave me data from the gyroscope sensor in serial port.
```
void setup()
{
Serial.begin(115200);
}
void loop()
{
Serial.println("Hello World");
}
```
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
I had an `MPU9250` sensor connecting by I2C bus `SDA-PB7`, `SCL-PB6` and the microcontroller received data on this bus from the sensor and transferred them to the `UART` port, i.e. `COM` port, which was created by the `CH340G` chip.
I tested the board for about a week, and today the serial port stopped outputting data...only garbage.
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
I began to figure it out - when there is no device on the `I2C` bus, then the data quietly goes to the `UART` on the `CH340G` in the serial port, but even when there are devices, and the [sketch](https://github.com/todbot/arduino-i2c-scanner/blob/master/I2CScanner/I2CScanner.ino) is launched to check the address of the device, everything works.
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
When I install an `MPU9250` sensor or another device on the `I2C` bus and issue a port to the serial, nothing is output to the `UART`.
I have three `BlackPills` and I compared them.
If the debug board is not in `DFU` mode, then on the legs `PA9` and `PA10` 3.2 volts each.
If I switch the board to `DFU` mode, then on two "serviceable" BlackPills I have voltage levels on `PA9` and `PA10` near zero (to be precise, 0.12 volts), and on the "faulty" BlackPlil one on `PA9` 0 volts, and on `PA10` 3.2 volts .
If I press the `RESET` button, then the voltage level drops to `PA9`, and 3.2 volts remains on `PA10`.
On the other two BlackPills and on `PA9` and `PA10`, the level drops by 0 volts.
I wrote a sketch to press the legs to a low level, and played around with the `PA10` leg - and it is pressed to zero, only up to 0.45 volts, and then 3.2 volts.
Sketch below.
```
void setup() {
  pinMode(PA10, OUTPUT);
}

void loop() {
  digitalWrite(PA10, LOW); /
  delay(3000); /
  digitalWrite(PA10, HIGH);
  delay(3000);
}

```
The documentation says that `PA10` is needed for OTG_USB.
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
In general, `PA10` is data reception, how does it affect the output of information from the `serial port`?
And `I2C` also fails ... maybe I have something with the timer?
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
What am I doing wrong, or did I spoil the `stm32f401ccu6` output of `PA10`?
The documentation says that all pins are 5 volt tolerant...
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
It’s very strange, if I don’t use the `I2C` bus, then I get the output to the serial `PA10` without problems, as soon as the `I2C` bus works, except for the sketch address scanner, the serial port does not output anything.

Closed 2023-08-13.

Thread 45 (2023-10-10):

Noisy 3.3v (is it a clone?)

bobemoe, 2023-10-10:
We are prototyping a big project using these and have probably used nearly 100 so far from different suppliers. We find some are having inaccurate ADC reading. We have traced this down to what we suspect is a noisy 3.3v supply. See below for some oscilloscope shots of the 3.3v rail on a good, ok and bad board respectively. All tests powered from the same stable 5v USB.

1. I suspect some are probably clones. Is there a definite way to check if they are clones or not?
2. Has anyone else seen this kind of noise on the 3.3 rail or could this issue be something else?
3. We may try replacing the regulator, what is the official regulator used on the genuine boards?

Good (Stable ADC readings)
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

OK (Slight errors in ADC)
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

Bad (Wildly off ADC)
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

WeActStudio, 2023-10-13:
Please check whether there is WeAct Studio V3.1 on the back of the board.

bobemoe, 2023-10-13:
We have a very varied selection of v3.1, v3.0 some with WeAct, some with WeAct Studio, some without and some blank! Many combinations!

I created a simple test code to measure the internal avref over 10 seconds and print the standard deviation.

All of the 3.1's with the official logo were the most stable.
The "bad" ones were all "WeAct v3.0" but also a lot of this type were good too.
All the others were acceptable but not as good as the 3.1's.

Think we must just have a lot of fakes. We want to buy a batch of official devices the link to official shop in the README is broken see https://github.com/WeActStudio/WeActStudio.MiniSTM32F4x1/issues/42

bobemoe, 2023-10-13:
Here is photos of all the devices I tested.
The black number is the test result (mV range of AVREF over 10secs)
The white number is our test id ref.

## BAD ( > 35mV )
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

## GOOD ( < 35mV )
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

WeActStudio, 2023-10-14:
The v3.0 you bought is fake. Now the boards we sell are all v3.1. This is a AliExpress link weactstudio.aliexpress.com

Thread 46 (2024-01-15):

presoldered headers

NRKorsakov, 2024-01-15:
Is there anywhere to buy this board with presoldered headers?

Thanks!

WeActStudio, 2024-01-16:
Not have this

---- Replied Message ----
| From | ***@***.***> |
| Date | 01/15/2024 21:46 |
| To | ***@***.***> |
| Cc | ***@***.***> |
| Subject | [WeActStudio/WeActStudio.MiniSTM32F4x1] presoldered headers (Issue #46) |

Is there anywhere to buy this board with presoldered headers?

Thanks!

—
Reply to this email directly, view it on GitHub, or unsubscribe.
You are receiving this because you are subscribed to this thread.Message ID: ***@***.***>

Thread 47 (2024-02-02):

Datasheet for STM32 F405 and F446

synersignart, 2024-02-02:
Hi would need explanation on these two board the STM32F405 and STM32F446 as there are very little documentation and schematics found online
particular on the SB jumper and the SD card  SDIO or SPI information

WeActStudio, 2024-02-02:
https://github.com/WeActStudio/WeActStudio.STM32F4_64Pin_CoreBoard.git

---- Replied Message ----
| From | Cliff ***@***.***> |
| Date | 02/02/2024 10:34 |
| To | ***@***.***> |
| Cc | ***@***.***> |
| Subject | [WeActStudio/WeActStudio.MiniSTM32F4x1] Datasheet for STM32 F405 and F446 (Issue #47) |

Hi would need explanation on these two board the STM32F405 and STM32F446 as there are very little documentation and schematics found online
particular on the SB jumper and the SD card SDIO or SPI information

—
Reply to this email directly, view it on GitHub, or unsubscribe.
You are receiving this because you are subscribed to this thread.Message ID: ***@***.***>

synersignart, 2024-02-02:
okie

synersignart, 2024-02-02:
Does the  PA8 needs to be active inorder to operate the TF?

Thread 48 (2024-07-14):

CMSIS-DAP wishlist

ALTracer, 2024-07-14:
Hello and thank you for those wonderful minimal boards. I have bought at least four of F411CE (+ w25q64) by now.
1. https://github.com/WeActStudio/WeActStudio.MiniSTM32F4x1/blob/d25a90e7bdcee32aaddefcbc841a0f0a547b2072/SDK/CMSIS-DAP/README.md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
While this command is okay for flashing,
`dfu-util -a "@Internal Flash  /0x08000000/04*016Kg,01*064Kg,03*128Kg" -s 0x08000000 -D CMSIS-DAP_WeActStudio.bin`
I have successfully used a different form and had it exit into the application immediately after reflashing: (CC @linuxtim)
`dfu-util -d 0483:df11 --alt 0 -s 0x08000000:leave -D CMSIS-DAP_WeActStudio.bin`
Or even flash your firmware using a Blackmagic Debug Firmware compatible board (connect under reset, because this DAP apparenly unmaps its SWJ-DP pins).
2. Why is the shipped binary presenting a fixed serial number of `0001A0000000` despite F401CC and F411CE have unique serial numbers at ST DESig UID_BASE 0x1FFF7A10? This makes it impossible to plug two such debuggers (or more) and address them from desktop software programs. You even refer to it in your project in `GetSTM32MCUID()` but USB callbacks should be configured to read, compute and return that value.
3. Why is the shipped binary only supporting HID transport but not Bulk vendor-specific transport? This is especially slow on Full-Speed devices like F401/F411. ARM CMSIS-DAP reference implementation may support both options.
4. Why is the shipped binary only supporting SWD, but not JTAG? Two extra pins is easy enough to configure and manage. This prohibits debug of JTAG-only targets, like RISC-V, and reprogramming FPGAs.
5. Why do you implement System Reset as a SWD sequence to AIRCR SYSRESETREQ, and not as a GPIO open-drain pull low? Most gdbservers can do a soft reset write already, but they can't tell the adapter to pull its nSRST pin low otherwise. This is important for debugging some of the targets.
6. Why is the shipped binary missing a Virtual COM port secondary interface? Most debug firmware solutions provide a UART-USB channel to communicate with the debugged device. Is it related to the 1+3 endpoints limitation of DWC2 OTGFS in F401/F411?
7. Can you please convert the Keil project into something I could import in, say, Eclipse MCU CDT? Or I should recreate an STM32CubeIDE project for this?

`c251:f001 Keil Software, Inc. WeAct CMSIS-DAP`

```
Info : CMSIS-DAP: SWD supported
Info : CMSIS-DAP: Atomic commands supported
Info : CMSIS-DAP: Test domain timer supported
Info : CMSIS-DAP: SWO streaming trace supported
Info : CMSIS-DAP: FW Version = 2.0.0
Info : CMSIS-DAP: Interface Initialised (SWD)
```
```
Black Magic Debug App v1.10.0-898-g4e482088
 for Black Magic Probe, ST-Link v2 and v3, CMSIS-DAP, J-Link and FTDI (MPSSE)
Using c251:f001 0001A0000000 CMSIS-DAP by ARM
 WeAct CMSIS-DAP ---
Using hid transfer
CMSIS-DAP v2.0.0, Capabilities: 71 (SWD, Atomic commands)
Adaptor supports DAP SWD sequences
```
```
## => Board Name | Unique ID
-- -- ----------------------
 0 => CMSIS-DAP by ARM WeAct CMSIS-DAP | 0001A0000000
 ```

Thread 49 (2024-09-22):

STM32F4x1 note detected by MiniDebugger ST-LINK V2.1

justinjools22, 2024-09-22:
Hi, I have been using WeActStudio.Mini STM32F11CEU6 Black MCU for several months with no errors and suddenly today I can't upload anymore.

I have been trying the ST-LINK utility to connect. It connects to STM32F103C6 Blue but not STM32F11CEU6 Black MCU. I have also tried with brand new STM32F11CEU6 and it doesn't connect either. I suspect it's something to do with the ST-LINK driver but have updated this to latest version or it's STM32Cube software but have reinstalled this as well.

justinjools22, 2024-09-22:
I just discovered it connects if I hold the reset button down and do "Connect under reset" using ST-LINK utility.

I tried again with blink sketch on Arduino IDE and got it working:
Holding down reset button while compiling then releasing just before uploading.

Now it connects every time. I guess it resets the board.
