WeActStudio/WeActStudio.MiniSTM32F4x1/HDK/MiniF4x1Cx_V31 Board Shape 外形.pdf

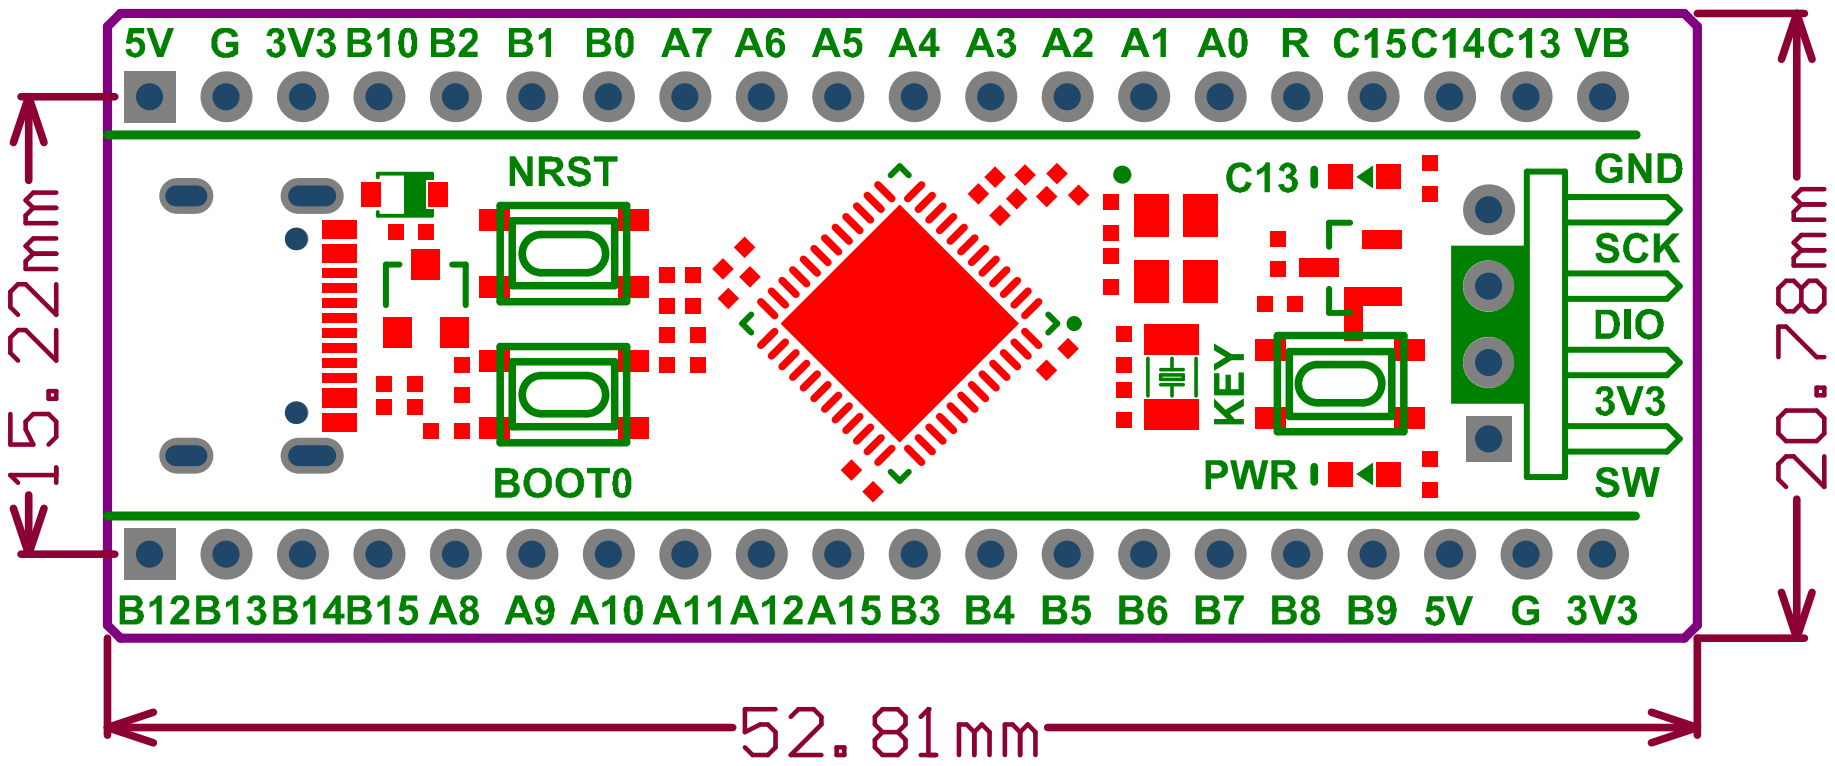
[picture p38: page 1]

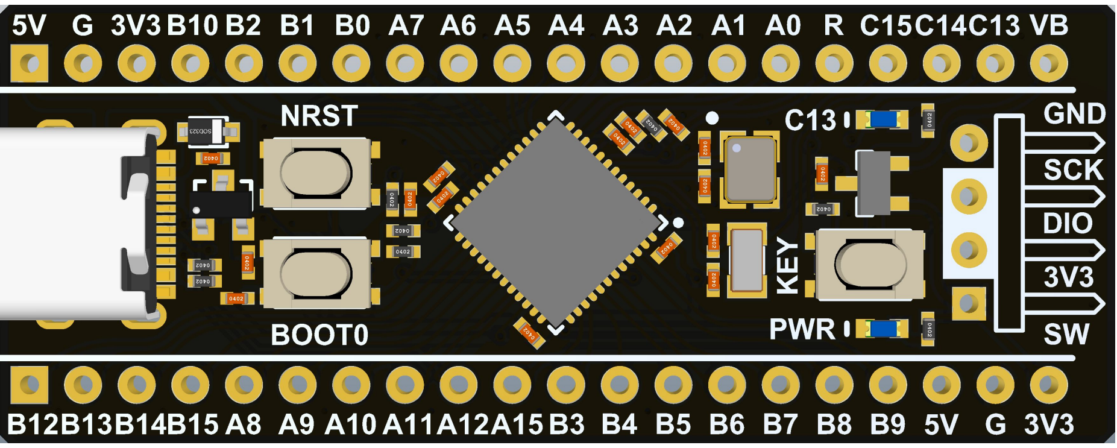
[picture p39: page 2]

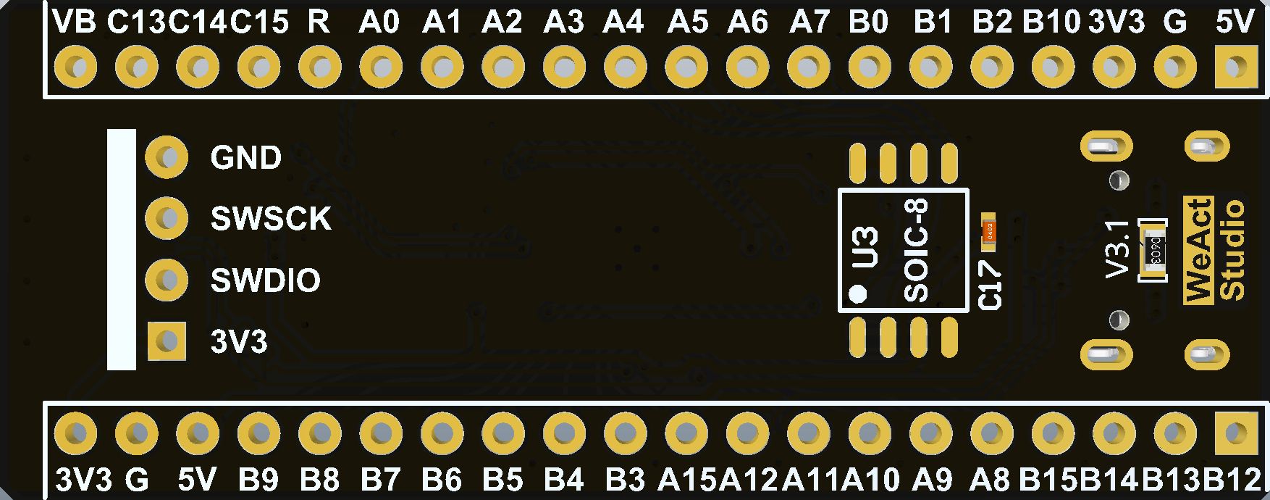
[picture p40: page 3]
