WeActStudio/WeActStudio.MiniSTM32F4x1/HDK/MiniF4x1Cx_V31.pdf

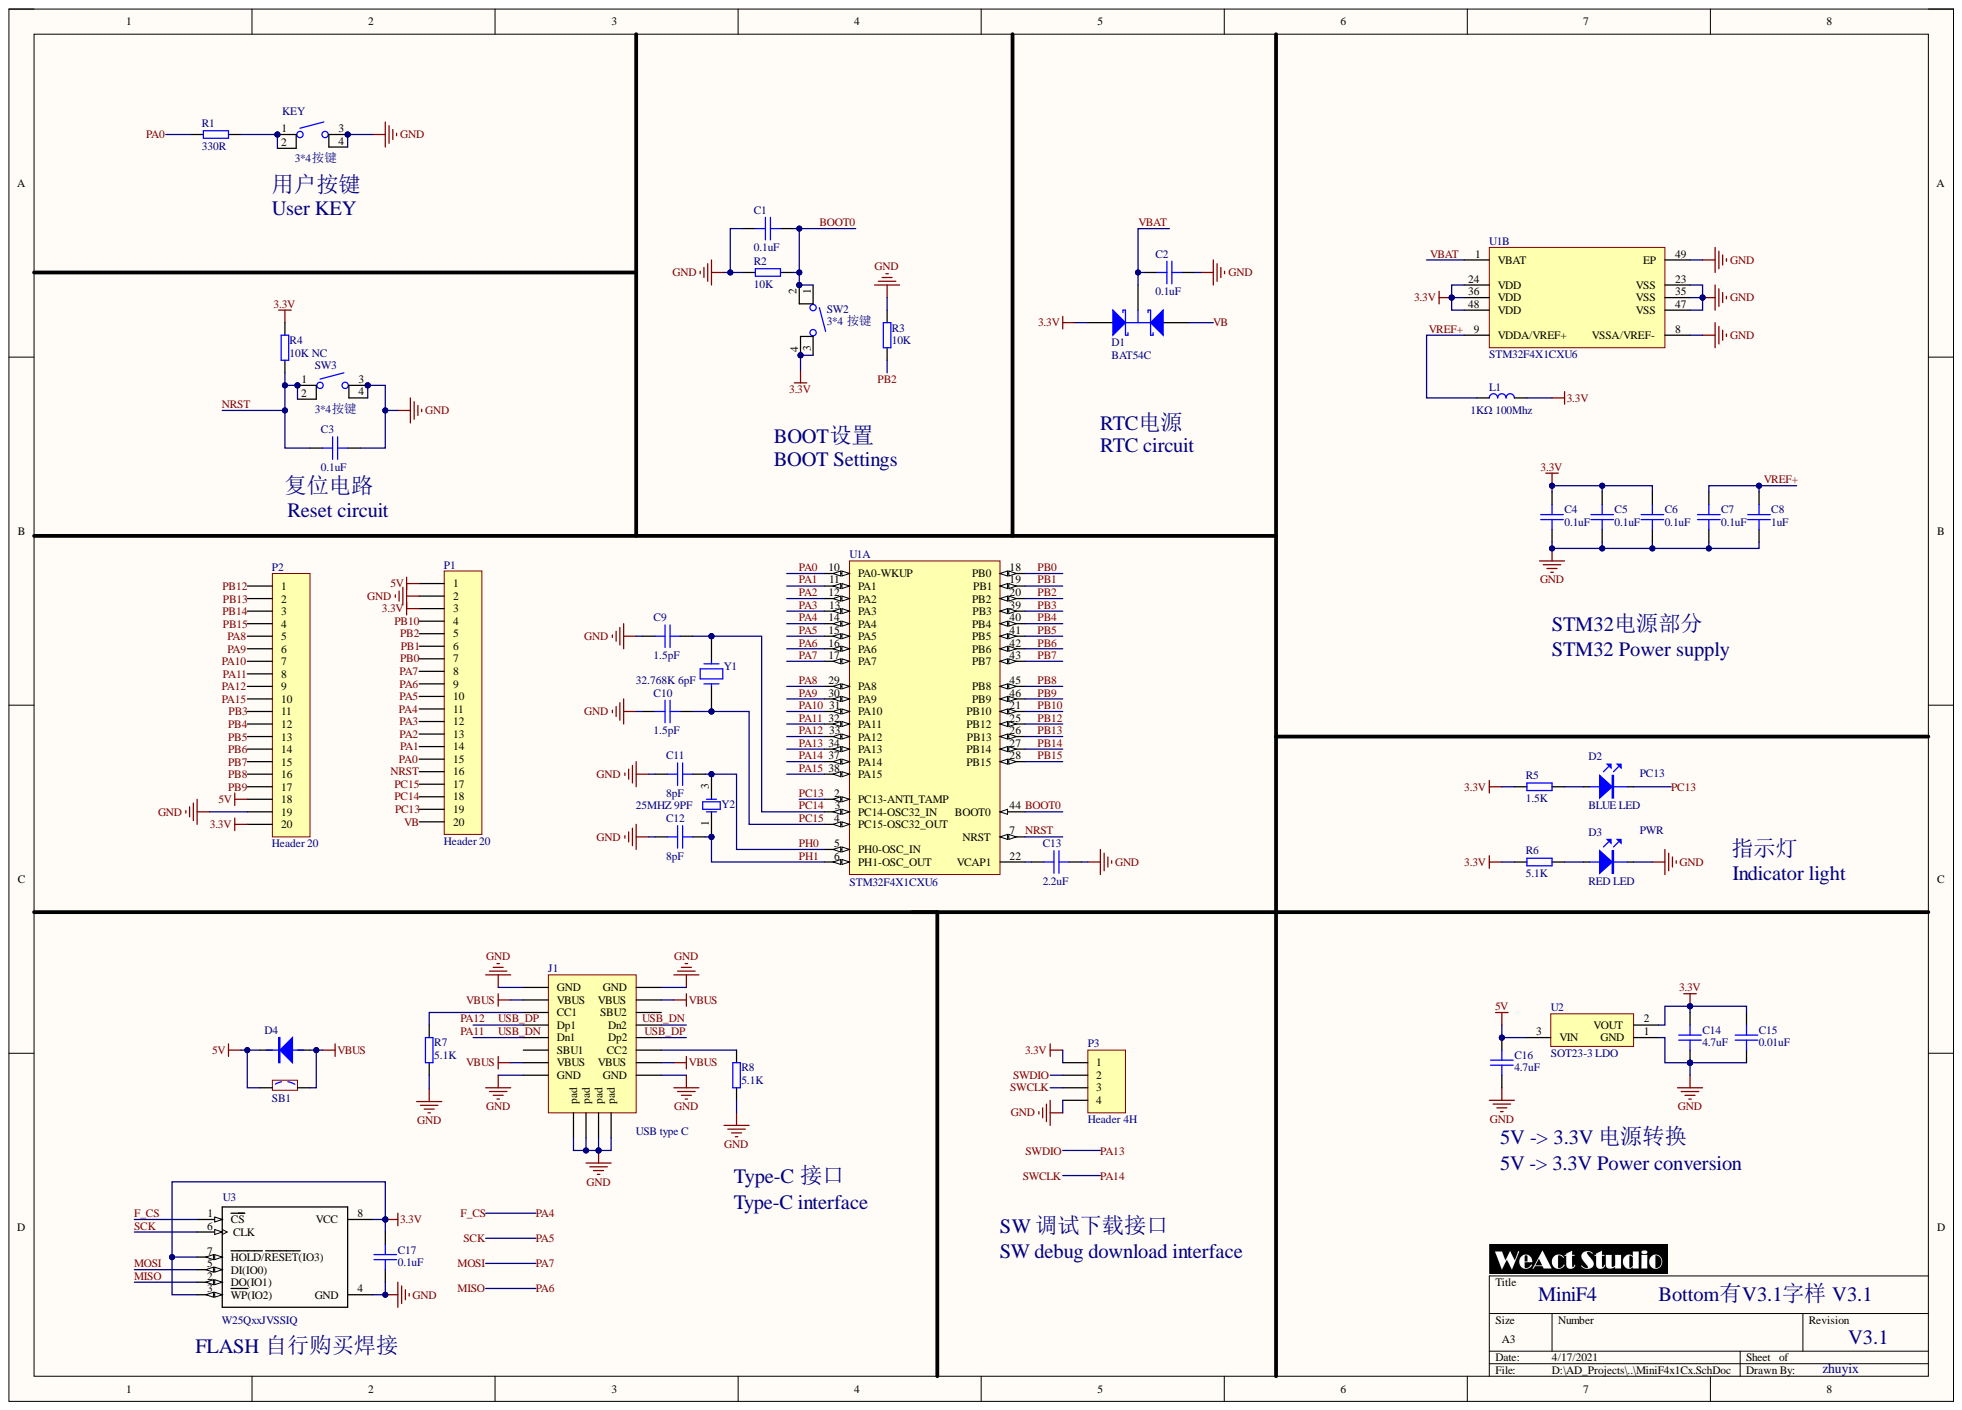
[picture p41: page 1]

PH1-OSC_OUT 6

SW 调试下载接口
SW debug download interface
