WeActStudio/WeActStudio.MiniSTM32F4x1/HDK/MiniF4x1Cx_V30 Board Shape 外形.pdf

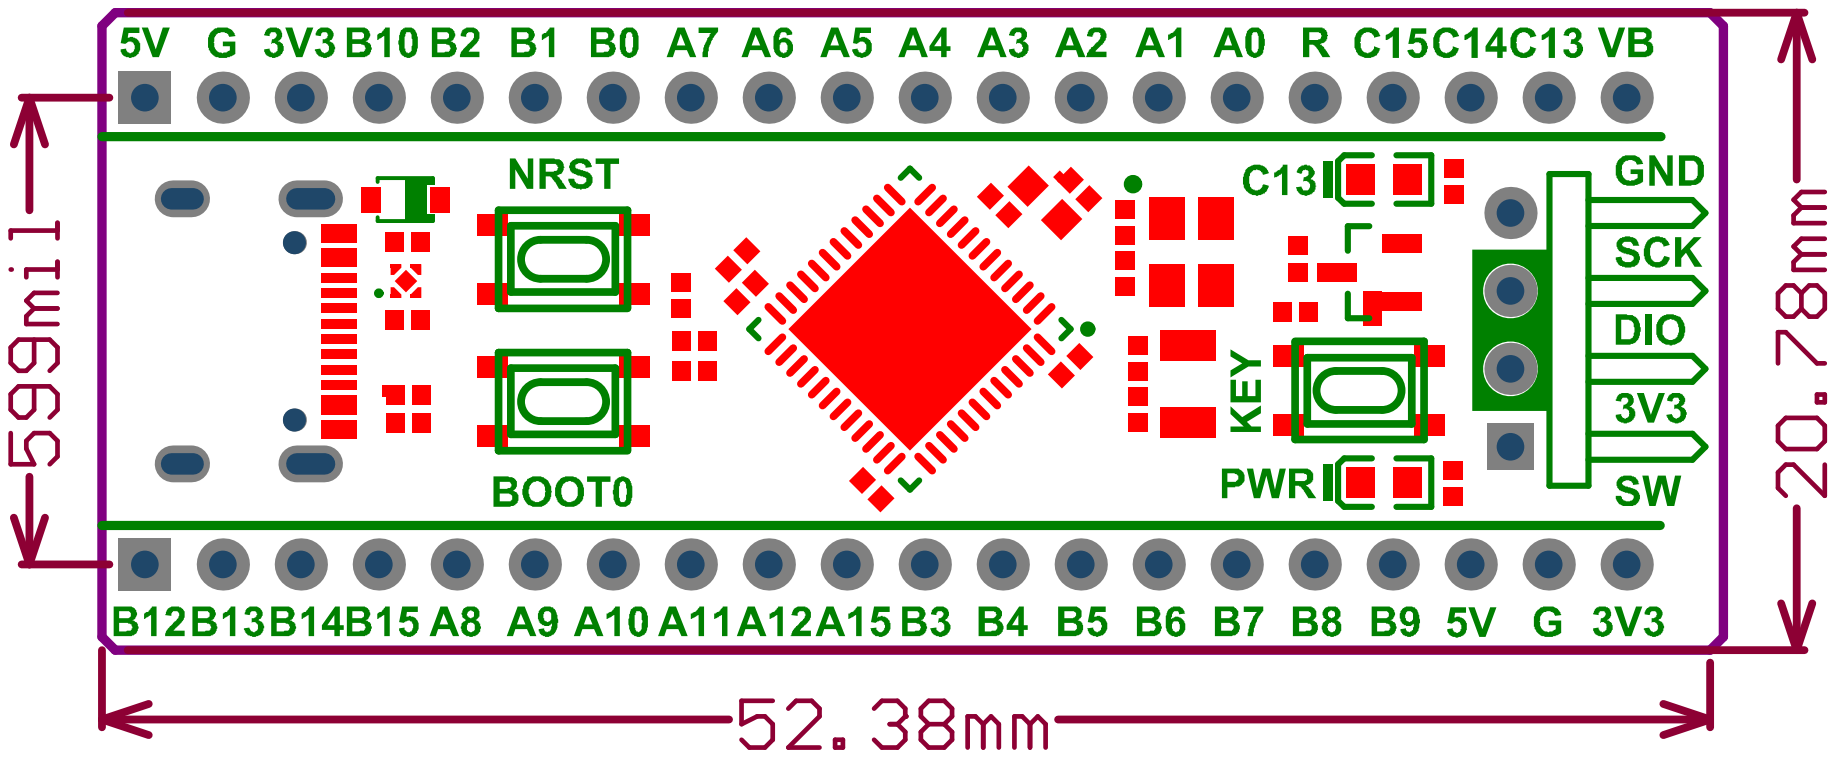
[picture p43: page 1]

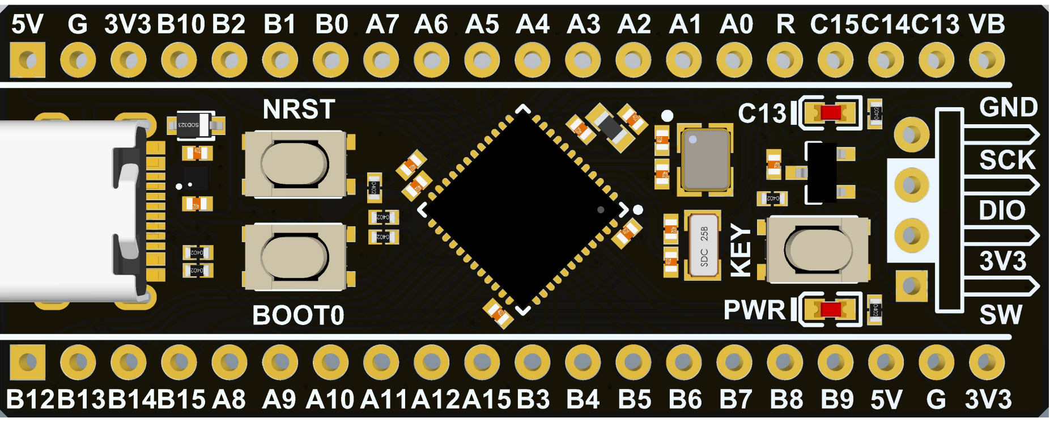
[picture p44: page 2]

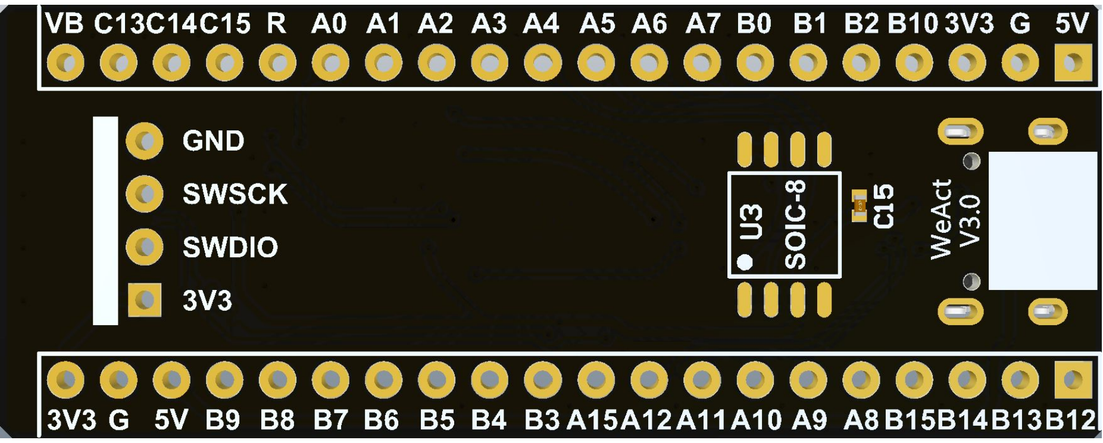
[picture p45: page 3]
