WeActStudio/WeActStudio.MiniSTM32F4x1/HDK/MiniF4x1Cx_V13 Board Shape 外形.pdf

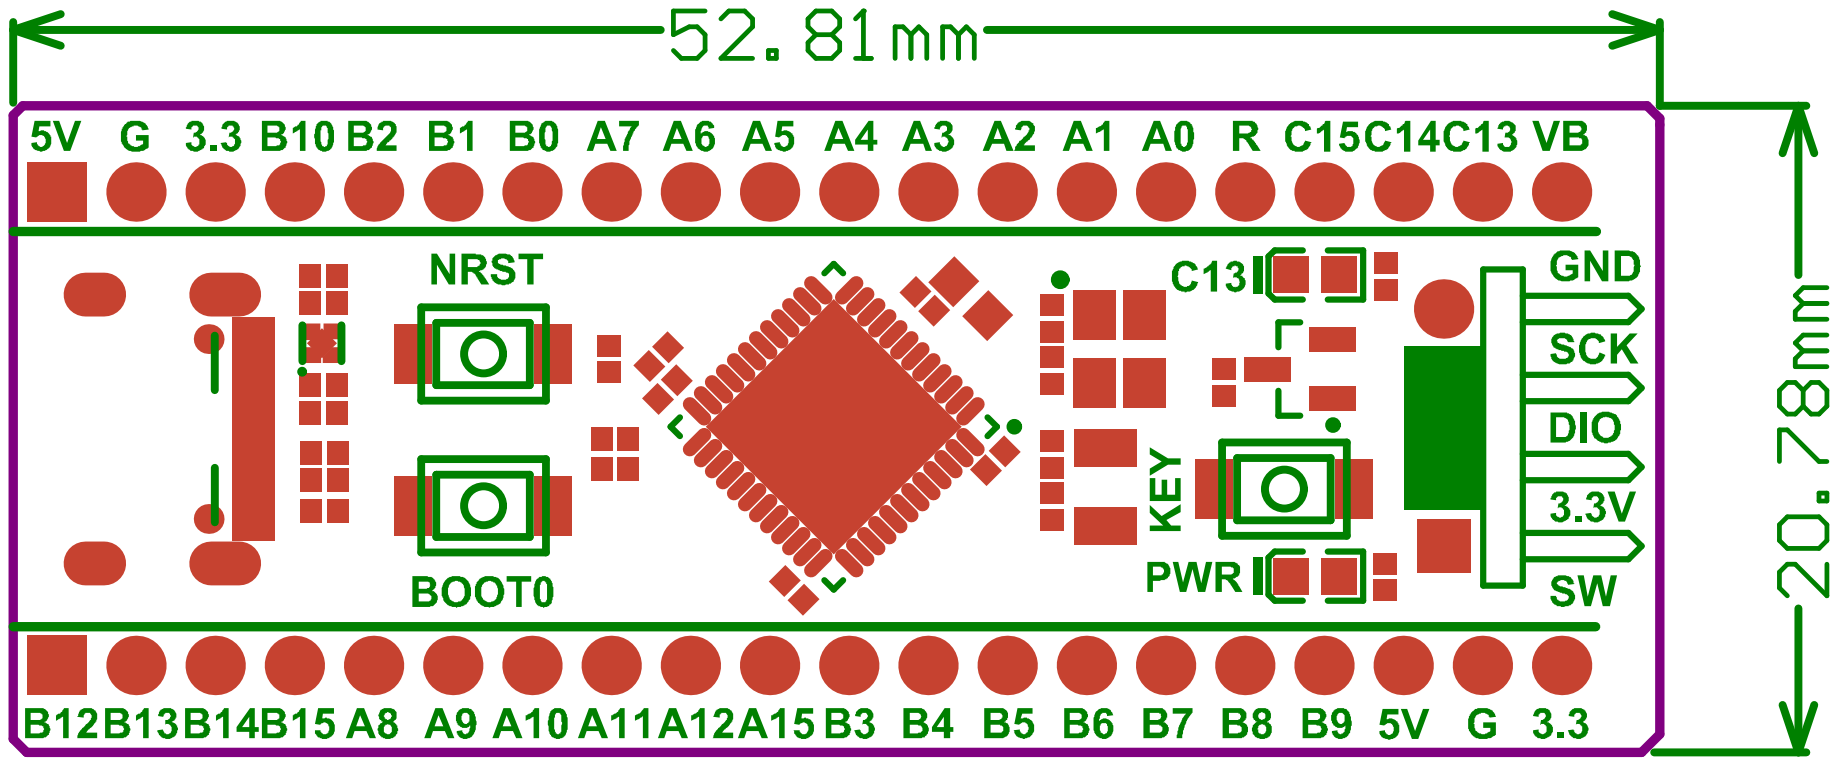
[picture p48: page 1]
