WeActStudio/WeActStudio.MiniSTM32F4x1/HDK/MiniF4x1Cx_V13 SchDoc.pdf

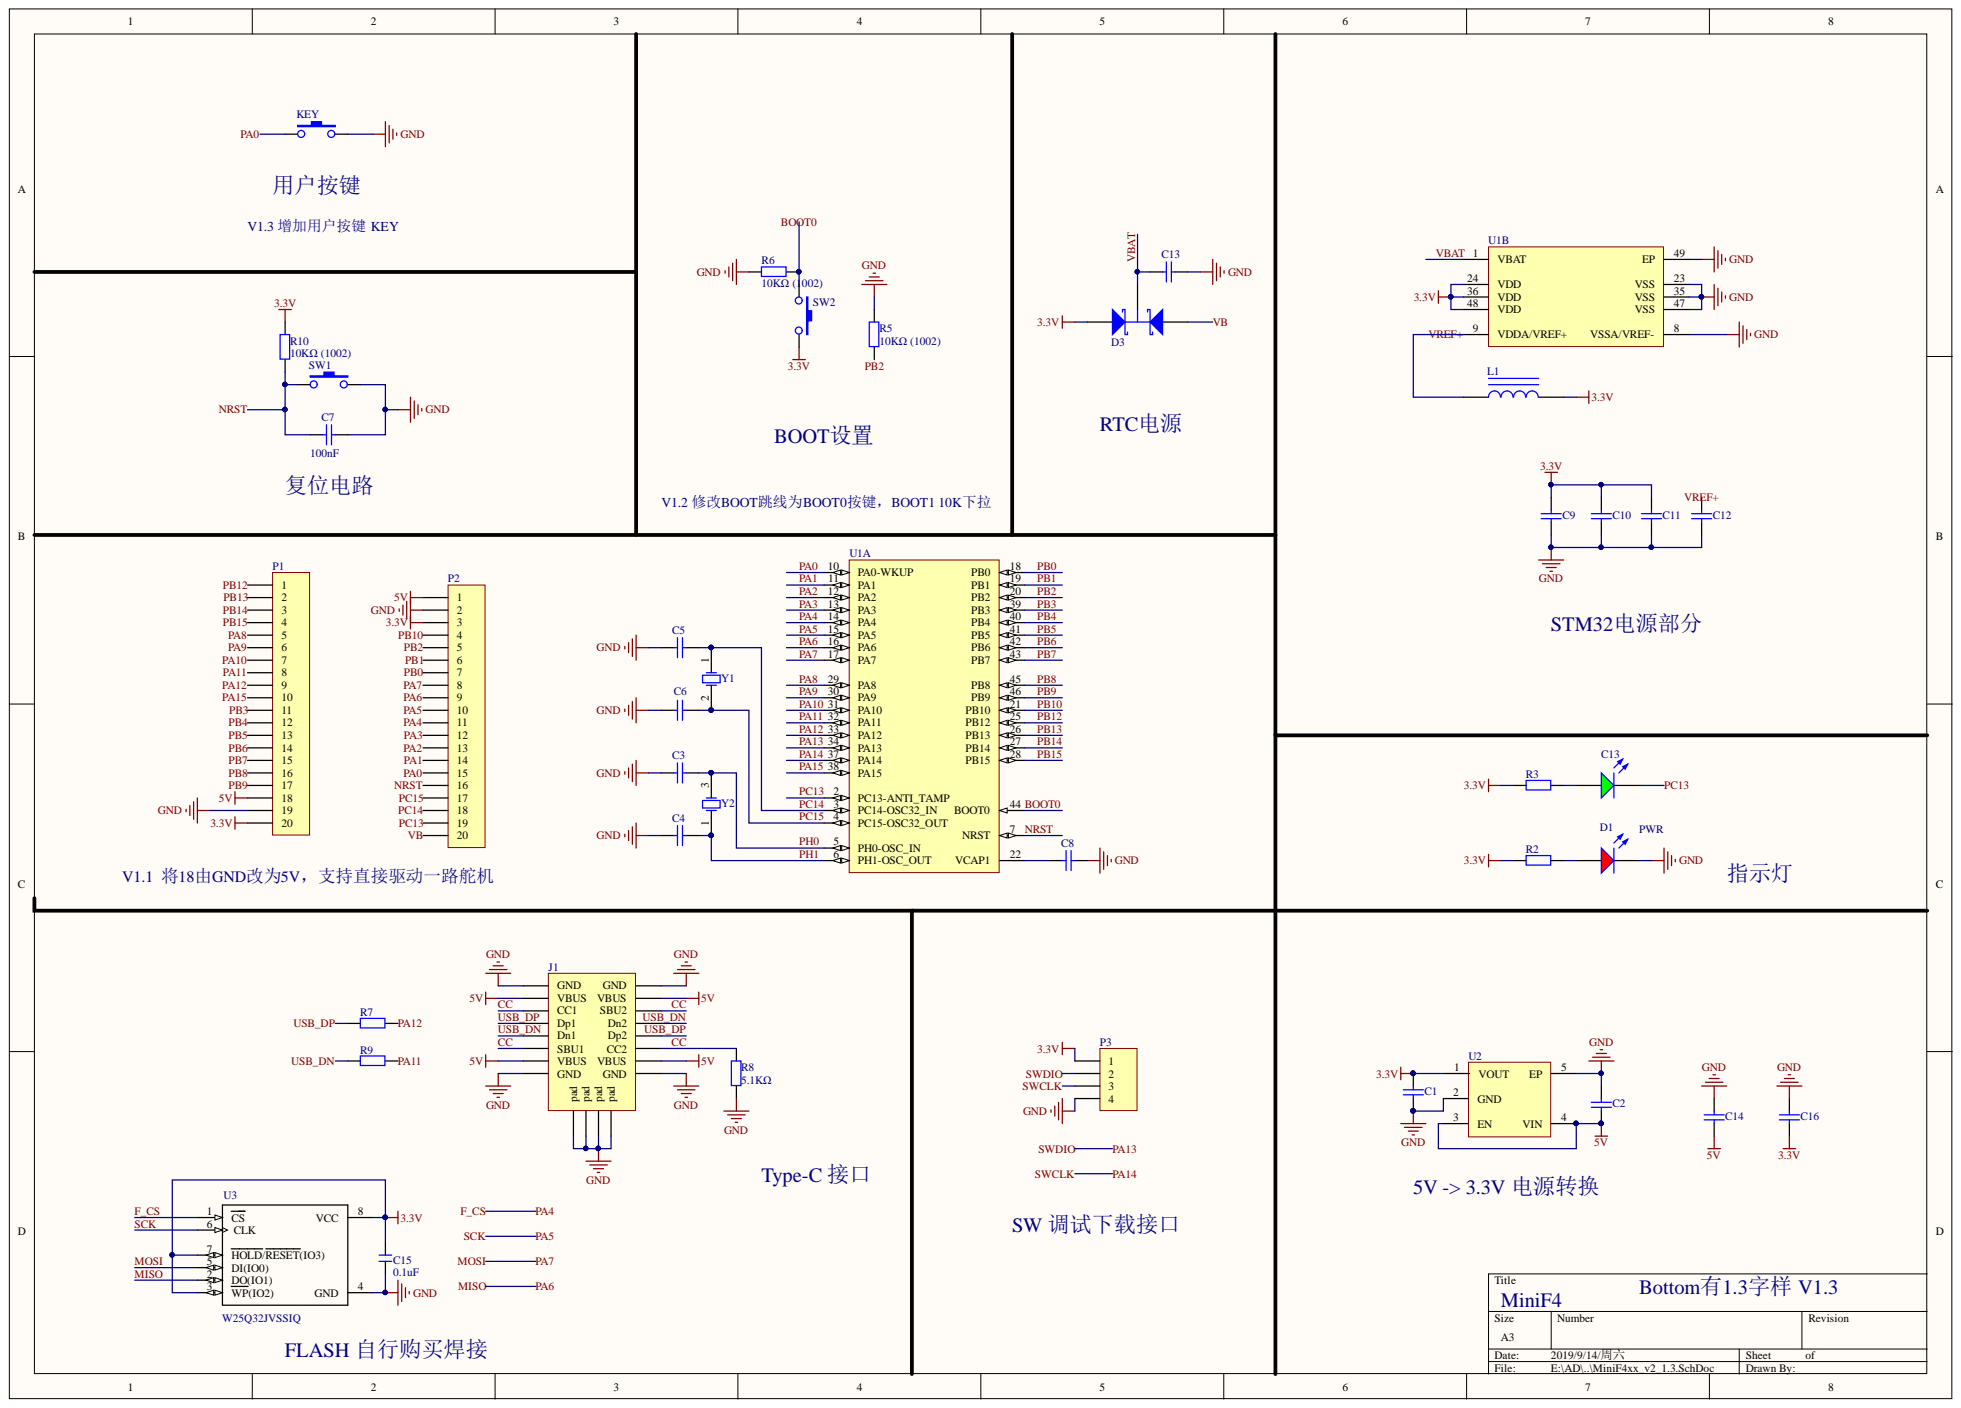
[picture p49: page 1]

PH0-OSC_IN 5
