WeActStudio/WeActStudio.MiniSTM32F4x1/HDK/MiniF4x1Cx_V20 Board Shape 外形.pdf

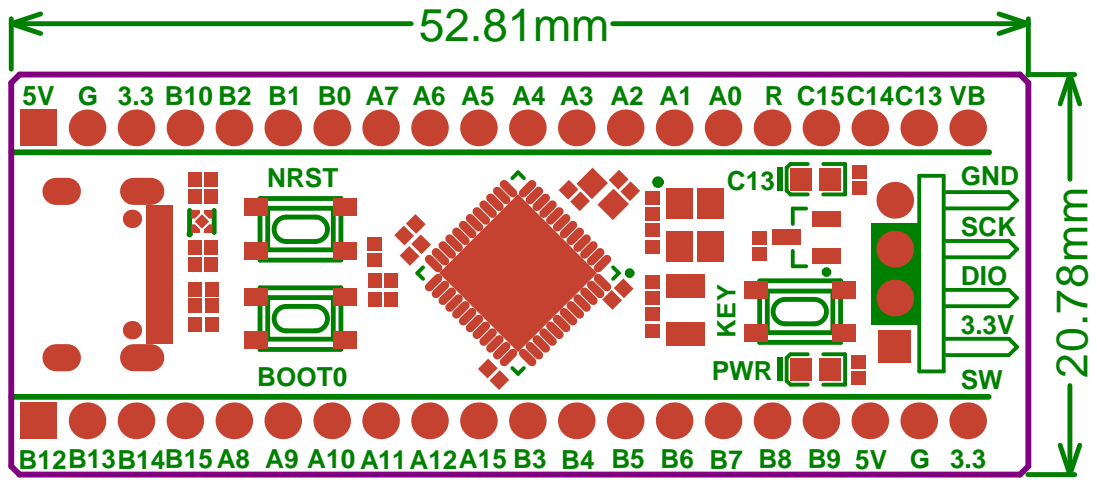
[picture p50: page 1]
