WeActStudio/WeActStudio.MiniSTM32F4x1/Soft/STM32_HID_Bootloader/bootloader/F4/Src/main.c

/*******************************************************************************
  *
  * HID bootloader for STM32F407 MCU
  *
  ******************************************************************************
  * 
  *	Created by: Vassilis Serasidis
  *       Date: 28 June 2018
  *       Home: http://www.serasidis.gr
  *      email: avrsite@yahoo.gr, info@serasidis.gr
  *
  ******************************************************************************

  ******************************************************************************
  * @file           : main.c
  * @brief          : Main program body
  ******************************************************************************
  * This notice applies to any and all portions of this file
  * that are not between comment pairs USER CODE BEGIN and
  * USER CODE END. Other portions of this file, whether 
  * inserted by the user or by software development tools
  * are owned by their respective copyright owners.
  *
  * Copyright (c) 2018 STMicroelectronics International N.V. 
  * All rights reserved.
  *
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
  ******************************************************************************
  */
/* Includes ------------------------------------------------------------------*/
#include "main.h"
#include "stm32f4xx_hal.h"
#include "usb_device.h"
#include "stm32f4xx_ll_rtc.h"
#include "stm32f4xx_ll_pwr.h"
/* USER CODE BEGIN Includes */

/* USER CODE END Includes	*/


/* USER CODE BEGIN PV */

uint8_t USB_RX_Buffer[HID_RX_SIZE];
uint8_t USB_TX_Buffer[8]; //USB data -> PC
static uint8_t CMD_SIGNATURE[7] = {'B','T','L','D','C','M','D'};

/* Command: <Send next data pack> */
static uint8_t CMD_DATA_RECEIVED[8] = {'B','T','L','D','C','M','D',2};
uint8_t new_data_is_received = 0;
static uint8_t pageData[SECTOR_SIZE];
typedef void (*funct_ptr)(void);

uint32_t magic_val;
uint16_t erase_page = 1;

/* USER CODE END PV */

void SystemClock_Config(void);
static void MX_GPIO_Init(void);

/* USER CODE BEGIN PFP */
void write_flash_sector(uint32_t currentPage);
extern uint8_t USBD_CUSTOM_HID_SendReport(USBD_HandleTypeDef *pdev, uint8_t *report, uint16_t len);

/* USER CODE END PFP */

/**
  * @brief  The application entry point.
  *
  * @retval None
  */
int main(void)
{
  /* MCU Configuration----------------------------------------------------------*/

  /* Reset of all peripherals, Initializes the Flash interface and the Systick. */
  HAL_Init();

  /* Configure the system clock */
  SystemClock_Config();

  /* USER CODE BEGIN SysInit */

  /* USER CODE BEGIN SysInit */
  MX_GPIO_Init();
   
  HAL_Delay(100);
  
  magic_val = LL_RTC_BAK_GetRegister(RTC, HID_MAGIC_NUMBER_BKP_INDEX);
  
  /* In case of incoming magic number or <BOOT_1_PIN> is LOW,
    jump to HID bootloader */
#if Is_WeAct_Board == 1 
  if ((HAL_GPIO_ReadPin(BOOT_1_PORT, BOOT_1_PIN) != BOOT_1_ENABLED)) {
    HAL_GPIO_WritePin(LED_1_PORT, LED_1_PIN, GPIO_PIN_SET);	
#else
  if ((magic_val != 0x424C)&&(HAL_GPIO_ReadPin(BOOT_1_PORT, BOOT_1_PIN) != BOOT_1_ENABLED)) {
#endif
    if(((*(__IO uint32_t*)FLASH_BASE + USER_CODE_OFFSET) & 0x2FF80000 ) == 0x20000000) {
      typedef void (*pFunction)(void);
      pFunction Jump_To_Application;
      uint32_t JumpAddress;
      
      JumpAddress = *(__IO uint32_t*) (FLASH_BASE + USER_CODE_OFFSET + 4);
      Jump_To_Application = (pFunction) JumpAddress;
      __set_MSP(*(uint32_t *) (FLASH_BASE + USER_CODE_OFFSET));
      
      Jump_To_Application(); 
    }
  }
  
  /* Reset the magic number backup memory */
  
  /* Enable Power Clock */
  __HAL_RCC_PWR_CLK_ENABLE();
  
  /* Allow access to Backup domain */
  LL_PWR_EnableBkUpAccess();
  
  LL_RTC_BAK_SetRegister(RTC, HID_MAGIC_NUMBER_BKP_INDEX, 0);
  
  /* Forbid access to Backup domain */
  LL_PWR_DisableBkUpAccess();
  
  /* USER CODE END SysInit */
  
  /* Initialize all configured peripherals */
  
  MX_USB_DEVICE_Init();

  /* USER CODE BEGIN 2 */
                                               
  static volatile uint32_t current_Page = (USER_CODE_OFFSET / 1024);
  static volatile uint16_t currentPageOffset = 0;
                                                           
  /* USER CODE END 2 */

  /* Infinite loop */
  /* USER CODE BEGIN WHILE */
  while (1) {
    if (new_data_is_received == 1) {
      new_data_is_received = 0;
      if (memcmp(USB_RX_Buffer, CMD_SIGNATURE, sizeof (CMD_SIGNATURE)) == 0) {
        switch(USB_RX_Buffer[7]){
          case 0x00:

          /*------------ Reset pages */
          current_Page = 16;
          currentPageOffset = 0;
          erase_page = 1;
          // HAL_GPIO_TogglePin(GPIOE, GPIO_PIN_0);	
          break;

        case 0x01:

          /*------------- Reset MCU */
          if (currentPageOffset > 0) {

          /* There are incoming
             data that are less
             than sector size
             (16384) */
            write_flash_sector(current_Page);
          }
          HAL_Delay(100);
          HAL_NVIC_SystemReset();
          break;
        }
      } else {
        memcpy(pageData + currentPageOffset, USB_RX_Buffer, HID_RX_SIZE);
        currentPageOffset += HID_RX_SIZE;
        if (currentPageOffset == SECTOR_SIZE) {
          write_flash_sector(current_Page);
          current_Page++;
          currentPageOffset = 0;
          CMD_DATA_RECEIVED[7] = 0x02;
          USBD_CUSTOM_HID_SendReport(&hUsbDeviceFS, CMD_DATA_RECEIVED, 8);
        }
      }
    }
  }

  /* USER CODE END WHILE */

}

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
/* USER CODE BEGIN 4 */
void write_flash_sector(uint32_t currentPage) {
  uint32_t pageAddress = FLASH_BASE + (currentPage * SECTOR_SIZE);
  uint32_t SectorError;

  HAL_GPIO_WritePin(LED_1_PORT, LED_1_PIN, GPIO_PIN_SET);	
  FLASH_EraseInitTypeDef EraseInit;
  HAL_FLASH_Unlock();
  
                                                                                                         

  /* Sector to the erase the flash memory (16, 32, 48 ... kbytes) */
  if ((currentPage == 16) || (currentPage == 32) ||
      (currentPage == 48) || (currentPage == 64) ||
      (currentPage % 128 == 0)) {
    EraseInit.TypeErase = FLASH_TYPEERASE_SECTORS;
    EraseInit.VoltageRange  = FLASH_VOLTAGE_RANGE_3;
    EraseInit.Banks = FLASH_BANK_1; 
    /* Specify sector number. Starts from 0x08004000 */
    EraseInit.Sector = erase_page++;
                                              
  

    /* This is also important! */
    EraseInit.NbSectors = 1;
    HAL_FLASHEx_Erase(&EraseInit, &SectorError);
  }

  uint32_t dat;
  for (int i = 0; i < SECTOR_SIZE; i += 4) {
    dat = pageData[i+3];
    dat <<= 8;
    dat += pageData[i+2];
    dat <<= 8;
    dat += pageData[i+1];
    dat <<= 8;
    dat += pageData[i];
    HAL_FLASH_Program(FLASH_TYPEPROGRAM_WORD, pageAddress + i, dat);
  }
  HAL_GPIO_WritePin(LED_1_PORT, LED_1_PIN,GPIO_PIN_RESET);  
  HAL_FLASH_Lock();
}
/* USER CODE END 4 */
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
