WeActStudio/WeActStudio.MiniSTM32F4x1/(commit log)

2020-01-01 Init Project
    [pins.csv]
2020-01-09 Squashed 'Soft/STM32_HID_Bootloader/' content from commit 7a23820
    git-subtree-dir: Soft/STM32_HID_Bootloader
    git-subtree-split: 7a238208c86c5f4ddff0651f9b555c27e786478f
2020-01-09 add soft/STM32_HID_Bootloader
2020-01-09 Squashed 'STM32F401CCU6-Black-Board/SDK/HAL/stm32f401_test/' content from commit 83b96dc
    git-subtree-dir: STM32F401CCU6-Black-Board/SDK/HAL/stm32f401_test
    git-subtree-split: 83b96dc9b67456d8b4caeabc13ddc53baca8e87b
2020-01-11 Add STM32F411 CubeIDE Example
2020-01-11 Add WeAct HID Bootloader STM32CubeIDE APP Setting.jpg
2020-01-13 Add V2.1 Board
2020-02-14 /STM32F411CEU6-Black-Board/SDK/micropython :fix Fw.hex bug
2020-03-01 Add STM32F411 V2.2 Version
2020-03-03 Update STM32F401CC MicroPython to V1.12
2020-03-12 update STM32F401&&STM32F411 Board Version to V3.0
2020-03-13 modified: STM32F411CEU6-Black-Board/HDK/README.md
2020-03-16 modified: STM32F4x1CxU6-Black-Board/HDK/README.md
2020-03-16 [hackswell] Initial commit of pin layout spreadsheet and derived PDF. Fixed wording in README.md.
    [STM32F4x1 v2.0+ Pin Layout.ods]
2020-03-26 add some doc && update README.md
    [pins.csv]
2020-05-10 Add High Quality 3D Model Render See Directory /images/STM32F4x1-3D-Model-Render/
2020-05-25 Add MicroPython 8MB SPI Flash Firmware
2020-06-17 Refactoring Directory,Add STM32F401CEU6 support
    [STM32F4xx_Clock_Configuration_V1.1.0.xls, pins.csv]
2020-06-30 Add MicroPython Example Add MicroPython SPIFlash Erase Firmware Add STM32F401CEU6/HAL/05-SPIFlash_Erase
2020-07-06 Update STM32F411 MicroPython Firmware Update Soft/WeAct Studio Download Tool
    [pins.csv]
2020-07-08 Update STM32F4x1CxU6 CoreBoard IntLib
2020-10-17 Add STM32F401CEU6 8MHz crystals support Update README.md
2020-10-31 Unsupport STM32F401CCU6 Core Board
    [STM32F4xx_Clock_Configuration_V1.1.0.xls, pins.csv]
2021-04-21 Hardware version upgrade to V3.1 * USB C support output 5V * Change LDO to ME6206A33XG * Change Logo to Metal logo
2021-04-21 Add Hardware Version V3.1 Board Shape
2021-05-15 STM32F411 Add WS2812 Sample Code
2023-05-30 update board version note
2023-12-11 update stm32f411 mpy firmware and Add stm32f411 8Mhz crystal oscillator support
2026-08-31 Add KiCAD symbol and foorprint with SWD with alternate functions defined on pins
2026-11-03 docs: point blog links to new post routes
    The blog migrated to a static site: /YYYY/MM/DD/slug/ became /posts/slug/.
    - STM32Download -> posts/stm32-download-tutorial
    - micropython -> posts/stm32f411ce-micropython-tutorial
    - WeAct-LogicAnalyzerV1 -> posts/pulseview-use-tutorial
    - fx2lafw driver zip is not on the new site, keep the old host
