WeActStudio/WeActStudio.MiniSTM32F4x1/(notices)

Notices in the files:
Soft/STM32_HID_Bootloader/cli/rs232.c:
This program is free software: you can redistribute it and/or modify
it under the terms of the GNU General Public License as published by
the Free Software Foundation, either version 3 of the License, or
(at your option) any later version.
Soft/STM32_HID_Bootloader/bootloader/F4/Src/main.c:
(C) COPYRIGHT STMicroelectronics *****END OF FILE
